joelvonrotz/KiCAD-Library/README.md

# KiCAD-Library

Collection of all my KiCAD Components (Footprints, 3D-Models &amp; Symbols)

I don't intend to commercialize anything from it, since some of the models here were take from the official kicad repository (and I don't know how legal it is to have a copy of the repository here &rarr; if you're a creator of one of those models or the script used to generate these and DON'T want to have them here, please message me!).

> [!important]
> Database not working, just added to work on it later
