joelvonrotz/KiCAD-Library/3dmodels/Package_QFP/CREDITS.md

# Extension by Joel

- These models have been take from https://gitlab.com/kicad/libraries/kicad-packages3D

---

## Footprint Library Credits

The credits of 3D models are listed in respective folder.  
Please fill all 3D models credits and info source data accordingly.  

### Info requirements:
- Author
- if the 3D model is script generated, a link to the script generator is required as well as the version and sw used
- if the 3D model is manually generated, include the source model @ https://github.com/KiCad/packages3D-source

<hr>  

### Housings_QFP.3dshapes:  
main author: Maurice easyw (others in script files)
3D step & wrl parametric models generated by scripts (step in scale 1:1 mm, wrl derived from step and scaled 1/2.54)  
[FCAD_script_generator](https://github.com/easyw/kicad-3d-models-in-freecad/tree/master/cadquery/FCAD_script_generator)  
release version of sw used to create models:  
- FreeCAD 0.17  
- CadQuery 0.5.2
