joelvonrotz/KiCAD-Library/3dmodels/Package_SO/CREDITS.md

# Extension by Joel

- These models have been take from https://gitlab.com/kicad/libraries/kicad-packages3D

---

## Footprint Library Credits

The credits of 3D models are listed in respective folder.  
Please fill all 3D models credits and info source data accordingly.  

### Info requirements:
- Author
- if the 3D model is script generated, a link to the script generator is required as well as the version and sw used
- if the 3D model is manually generated, include the source model @ https://github.com/KiCad/packages3D-source

<hr>

### Package_SO.3dshapes
main author: Maurice easyw (others in script files)
3D step & wrl parametric models generated by scripts (step in scale 1:1 mm, wrl derived from step and scaled 1/2.54)  
[FCAD_script_generator](https://github.com/easyw/kicad-3d-models-in-freecad/tree/master/cadquery/FCAD_script_generator)  
release version of sw used to create models:  
- FreeCAD 0.15 or FreeCAD 0.17 >= 10647  
- CadQuery 0.5.2  

SOIC-14_3.9x8.7mm_Pitch1.27mm  
SOIC-16W_7.5x10.3mm_Pitch1.27mm  
SOIC-16_3.9x9.9mm_Pitch1.27mm  
SOIC-18W_7.5x11.6mm_Pitch1.27mm  
SOIC-20W_7.5x12.8mm_Pitch1.27mm  
SOIC-24W_7.5x15.4mm_Pitch1.27mm  
SOIC-28W_7.5x17.9mm_Pitch1.27mm  
SOIC-8-1EP_3.9x4.9mm_Pitch1.27mm  
SOIC-8_3.9x4.9mm_Pitch1.27mm  
SOIJ-8_5.3x5.3mm_Pitch1.27mm  
MSOP-8-1EP_3x3mm_P0.65mm  
SSOP-20_5.3x7.2mm_P0.65mm  
TSSOP-14_4.4x5mm_P0.65mm  
QSOP-24_3.9x8.7mm_P0.635mm (https://github.com/easyw/kicad-3d-models-in-freecad/pull/31 joe-skb7)
ETSSOP-20-1EP_4.4x6.5mm_P0.65mm  
HTSSOP-20-1EP_4.4x6.5mm_P0.65mm_ThermalPad  
HTSSOP-28_4.4x9.7mm_P0.65mm_ThermalPad  
MSOP-10-1EP_3x3mm_P0.5mm  
MSOP-10_3x3mm_P0.5mm  
MSOP-12-16-1EP_3x4mm_P0.5mm  
MSOP-12-16_3x4mm_P0.5mm  
MSOP-12-1EP_3x4mm_P0.65mm  
MSOP-12_3x4mm_P0.65mm  
MSOP-16-1EP_3x4mm_P0.5mm  
MSOP-16_3x4mm_P0.5mm  
MSOP-8_3x3mm_P0.65mm  
OnSemi_Micro8  
PSOP-44_16.9x27.17mm_P1.27mm  
QSOP-16_3.9x4.9mm_P0.635mm  
SOP-16_4.4x10.4mm_P1.27mm  
SOP-4_4.4x2.8mm_P1.27mm  
SSOP-14_5.3x6.2mm_P0.65mm  
SSOP-16_3.9x4.9mm_P0.635mm  
SSOP-16_4.4x5.2mm_P0.65mm  
SSOP-16_5.3x6.2mm_P0.65mm  
SSOP-20_4.4x6.5mm_P0.65mm  
SSOP-24_3.9x8.7mm_P0.635mm  
SSOP-24_5.3x8.2mm_P0.65mm  
SSOP-28_5.3x10.2mm_P0.65mm  
SSOP-48_7.5x15.9mm_P0.635mm  
SSOP-56_7.5x18.5mm_P0.635mm  
SSOP-8_2.95x2.8mm_P0.65mm  
TSOP-I-48_12x18.4mm_P0.5mm  
TSOP-II-32_21.0x10.2mm_P1.27mm  
TSSOP-10_3x3mm_P0.5mm  
TSSOP-16-1EP_4.4x5mm_P0.65mm  
TSSOP-16_4.4x5mm_P0.65mm  
TSSOP-20_4.4x6.5mm_P0.65mm  
TSSOP-24_4.4x7.8mm_P0.65mm  
TSSOP-28_4.4x9.7mm_P0.65mm  
TSSOP-32_6.1x11mm_P0.65mm  
TSSOP-38_4.4x9.7mm_P0.5mm  
TSSOP-44_4.4x11.2mm_P0.5mm  
TSSOP-48_6.1x12.5mm_P0.5mm  
TSSOP-56_6.1x14mm_P0.5mm  
TSSOP-8_3x3mm_P0.65mm  
TSSOP-8_4.4x3mm_P0.65mm  
VSO-40_7.6x15.4mm_P0.762mm  
VSO-56_11.1x21.5mm_P0.75mm  
VSSOP-8_2.3x2mm_P0.5mm  
VSSOP-8_2.4x2.1mm_P0.5mm
SOP-4_3.8x4.1mm_P2.54mm

### Package_SO.3dshapes
main author: Stefan Olsson
3D step & wrl parametric models generated by scripts (step in scale 1:1 mm, wrl derived from step and scaled 1/2.54)  
[FCAD_script_generator](https://github.com/easyw/kicad-3d-models-in-freecad/tree/master/cadquery/FCAD_script_generator)  
release version of sw used to create models:  
- FreeCAD FreeCAD 0.17 Build 11223 64 bit Microsoft windwos platform https://www.freecadweb.org/

MFSOP6-4 (script)
MFSOP6-5 (script)
SO-20_12.8x7.5mm_Pitch1.27mm (modeled)
