joelvonrotz/KiCAD-Library/database/public_media/cache/thumbnail_md/media/part/23/mainimage-65ff1f30849ff.png

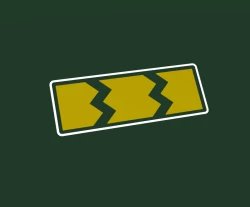
database/public_media/cache/thumbnail_md/media/part/23/mainimage-65ff1f30849ff.png
