joelvonrotz/KiCAD-Library/database/public_media/cache/thumbnail_md/media/part/24/mainimage-65ff1fbbb5337.png

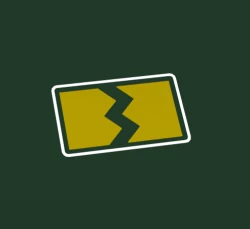
database/public_media/cache/thumbnail_md/media/part/24/mainimage-65ff1fbbb5337.png
