joelvonrotz/KiCAD-Library/database/public_media/cache/thumbnail_md/media/part/33/mainimage-65fecf4a8bd5e.png

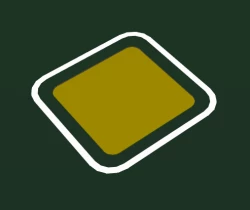
database/public_media/cache/thumbnail_md/media/part/33/mainimage-65fecf4a8bd5e.png
