joelvonrotz/KiCAD-Library/database/public_media/part/mainimage-66267fba0766b.png

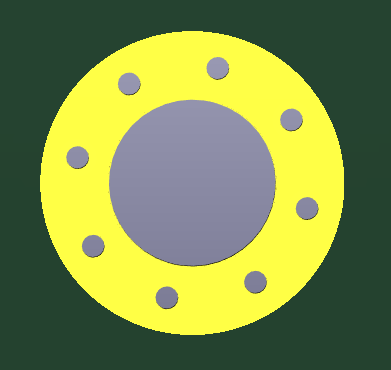
database/public_media/part/mainimage-66267fba0766b.png
