joelvonrotz/KiCAD-Library/3dmodels/Amphenol/sma_straight_tht_jack_132134.stp

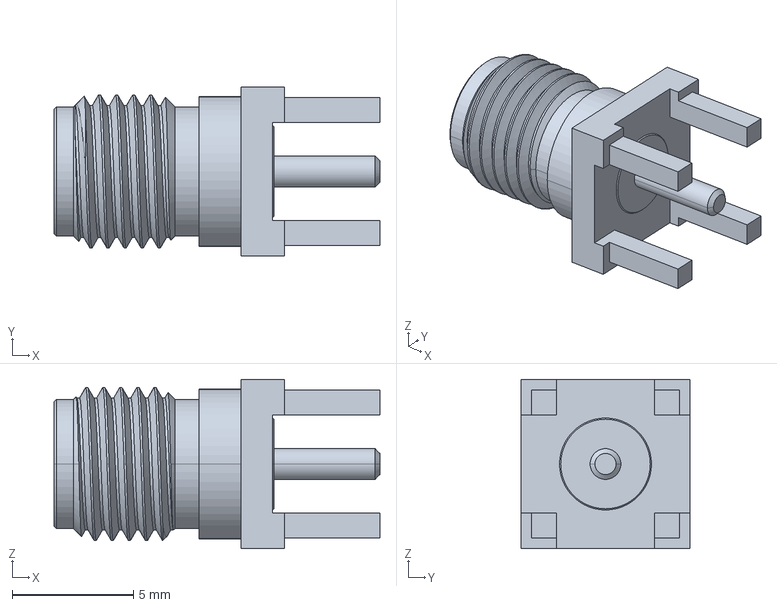
[picture p6: CAD file, 2024-11-03]
3dmodels/Amphenol/sma_straight_tht_jack_132134.stp
13.5 x 7.00 x 7.00 mm
