joelvonrotz/KiCAD-Library/3dmodels/Bourns/Resettable Multifuse/mf-msmf050.stp

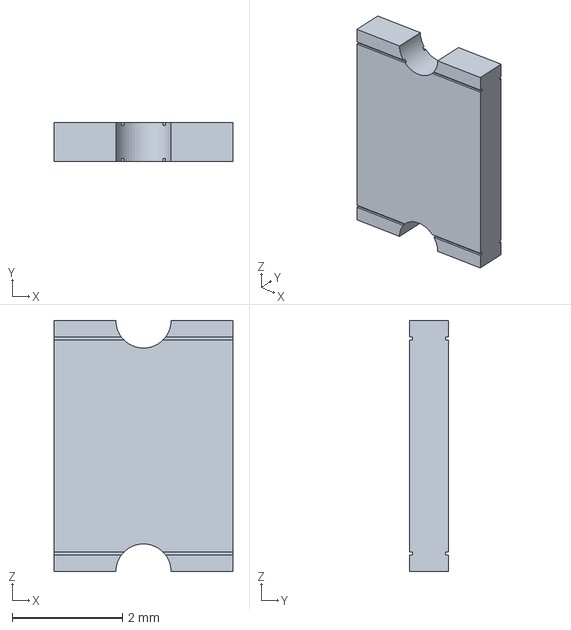
[picture p7: CAD file, 2021-02-06]
3dmodels/Bourns/Resettable Multifuse/mf-msmf050.stp
3.24 x 0.7 x 4.55 mm
