joelvonrotz/KiCAD-Library/3dmodels/C&K/tactile_button/PTS820J25KSMTRLFS.stp

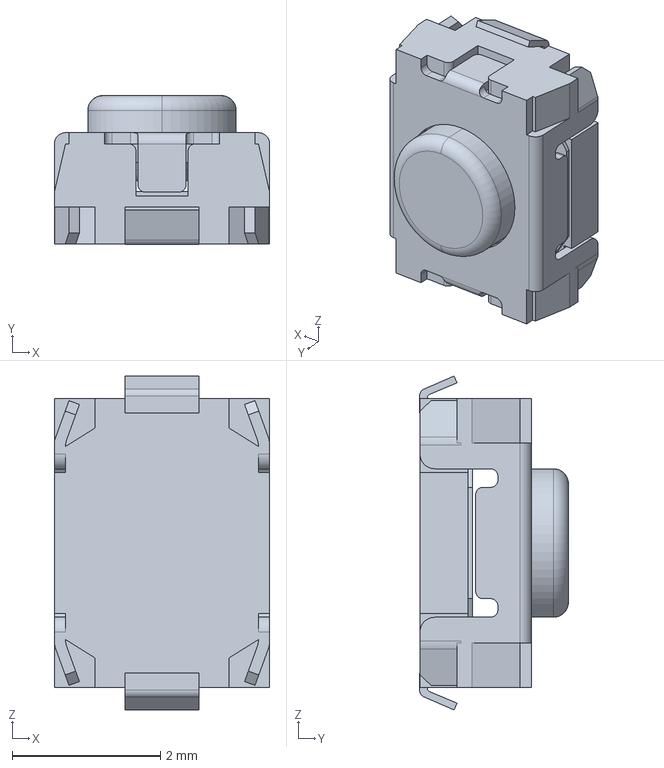
[picture p8: CAD file, 2024-05-29]
3dmodels/C&K/tactile_button/PTS820J25KSMTRLFS.stp
2.90 x 2.00 x 4.50 mm
