joelvonrotz/KiCAD-Library/3dmodels/capacitor/smd/CAP2225.stp

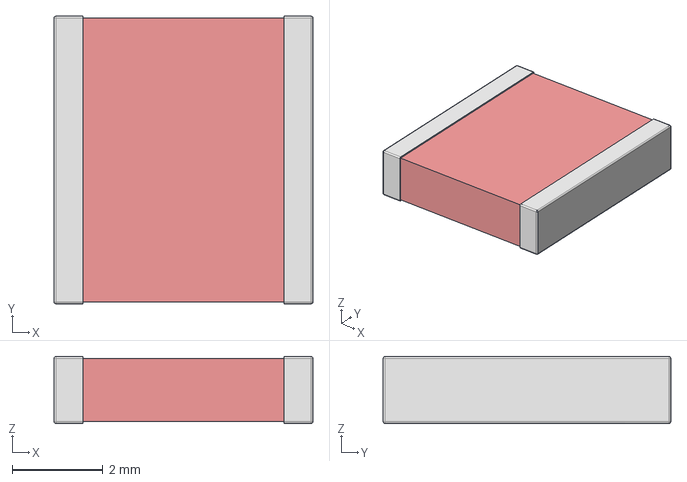
[picture p9: CAD file, 2021-02-06]
3dmodels/capacitor/smd/CAP2225.stp
5.72 x 6.35 x 1.48 mm
