joelvonrotz/KiCAD-Library/3dmodels/Discretes/DO-219AD v1.step

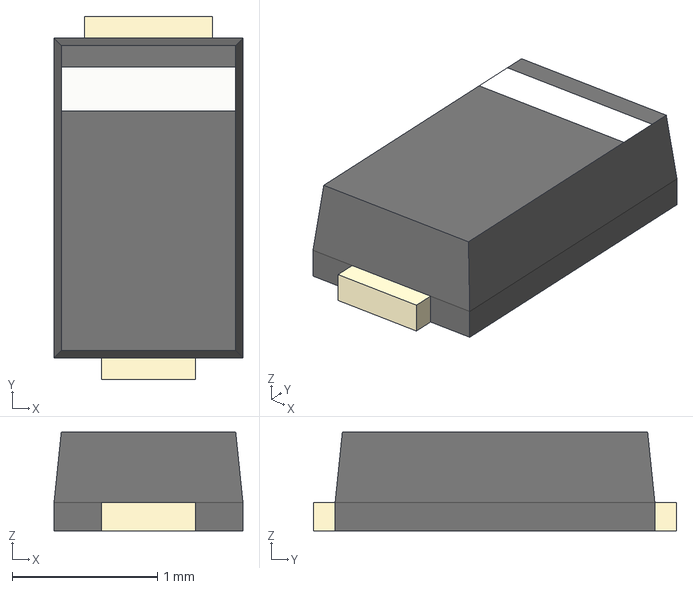
[picture p10: CAD file, 2021-02-06]
3dmodels/Discretes/DO-219AD v1.step
1.30 x 2.50 x 0.68 mm
