joelvonrotz/KiCAD-Library/3dmodels/Harwin/testpoints/S2751-46R.STEP

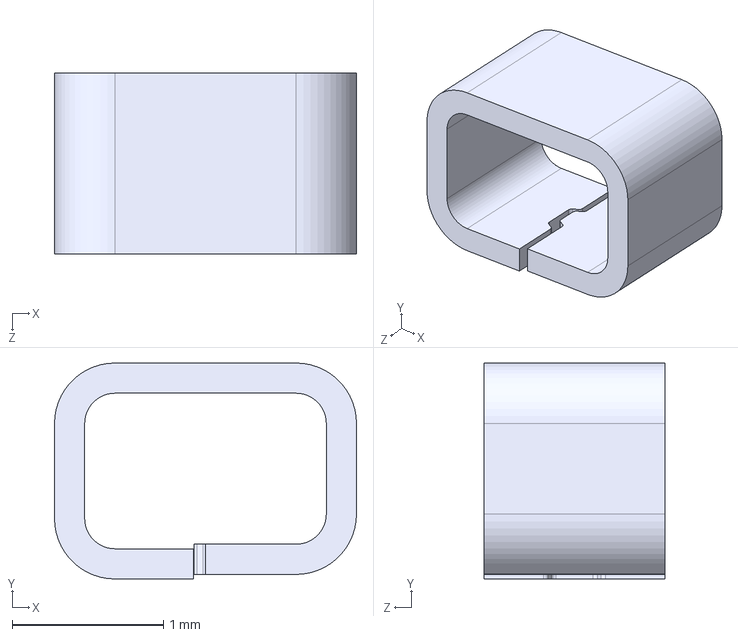
[picture p11: CAD file, 2024-11-03]
3dmodels/Harwin/testpoints/S2751-46R.STEP
2.00 x 1.43 x 1.20 mm
