joelvonrotz/KiCAD-Library/3dmodels/Kingbright/APT1608.STEP

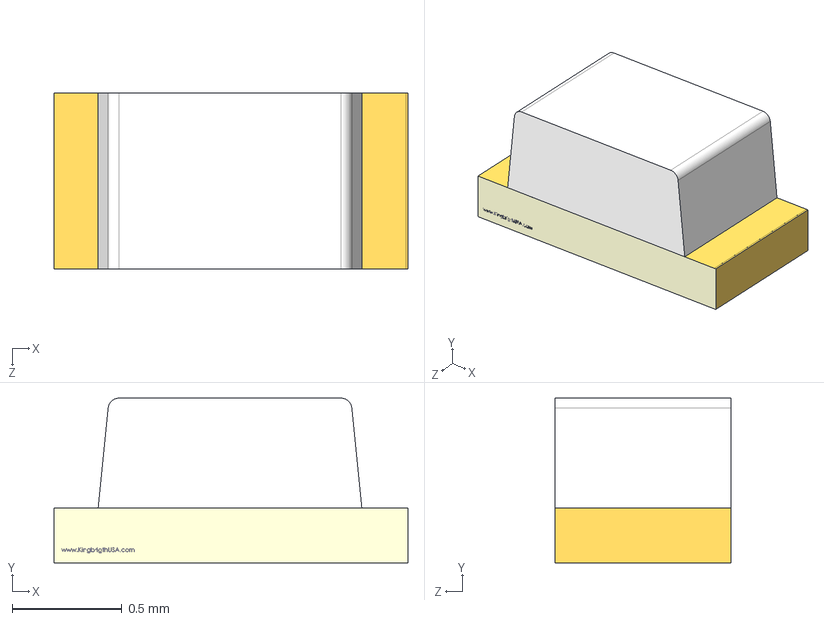
[picture p12: CAD file, 2024-11-03]
3dmodels/Kingbright/APT1608.STEP
1.61 x 0.75 x 0.8 mm
