joelvonrotz/KiCAD-Library/3dmodels/Murata/Inductor/LQG18HH68NJ00D.STEP

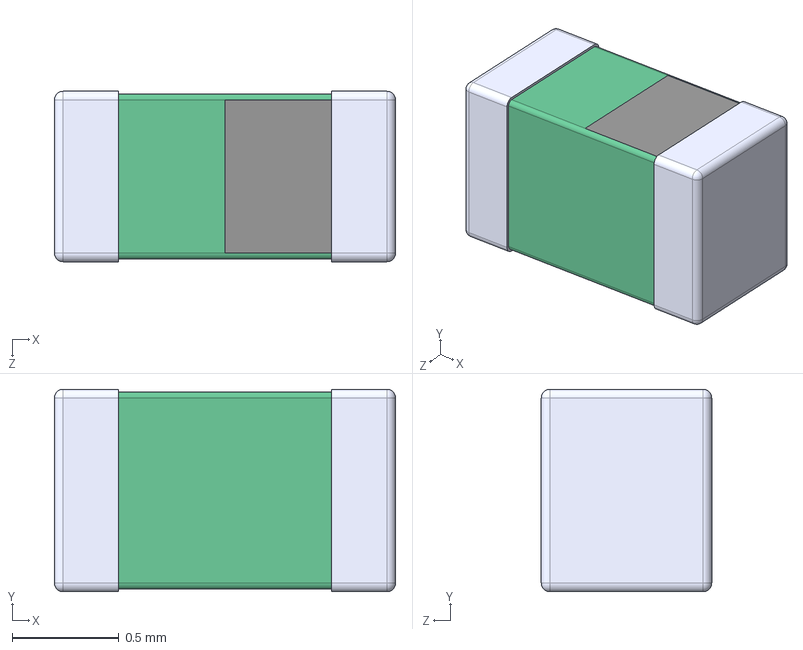
[picture p13: CAD file, 2024-11-04]
3dmodels/Murata/Inductor/LQG18HH68NJ00D.STEP
1.60 x 0.95 x 0.8 mm
