joelvonrotz/KiCAD-Library/3dmodels/Murata/Resonators/Murata_CSTNE_V v1.step

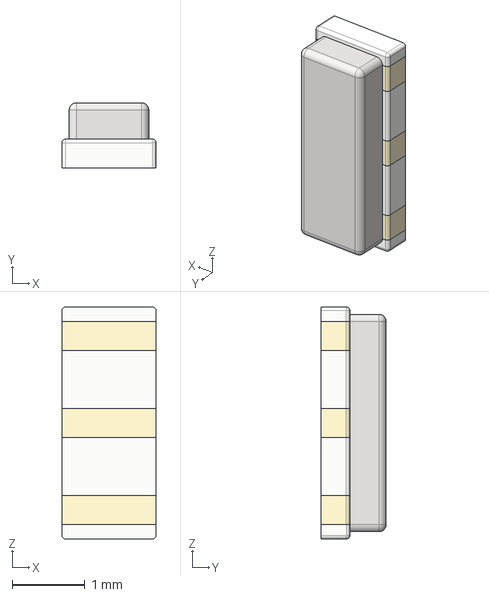
[picture p14: CAD file, 2021-02-06]
3dmodels/Murata/Resonators/Murata_CSTNE_V v1.step
1.30 x 0.9 x 3.20 mm
