joelvonrotz/KiCAD-Library/3dmodels/Package_ECS/ECS-3225_ECS.step

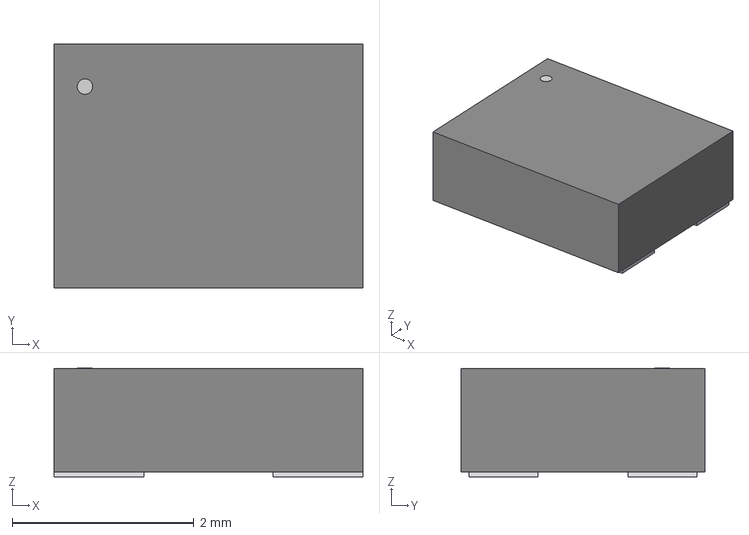
[picture p15: CAD file, 2024-03-18]
3dmodels/Package_ECS/ECS-3225_ECS.step
3.40 x 2.69 x 1.20 mm
