joelvonrotz/KiCAD-Library/3dmodels/Package_QFN/QFN-24-4x4mm_P0.5mm.step

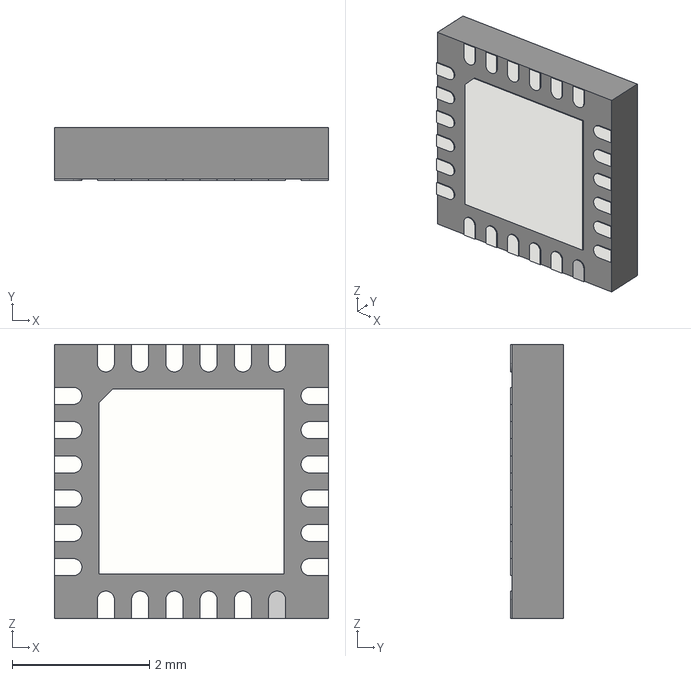
[picture p16: CAD file, 2024-05-29]
3dmodels/Package_QFN/QFN-24-4x4mm_P0.5mm.step
4.00 x 0.77 x 4.00 mm
