joelvonrotz/KiCAD-Library/3dmodels/Package_QFP/TQFP-100_14x14mm_P0.5mm_EP5x5mm.step

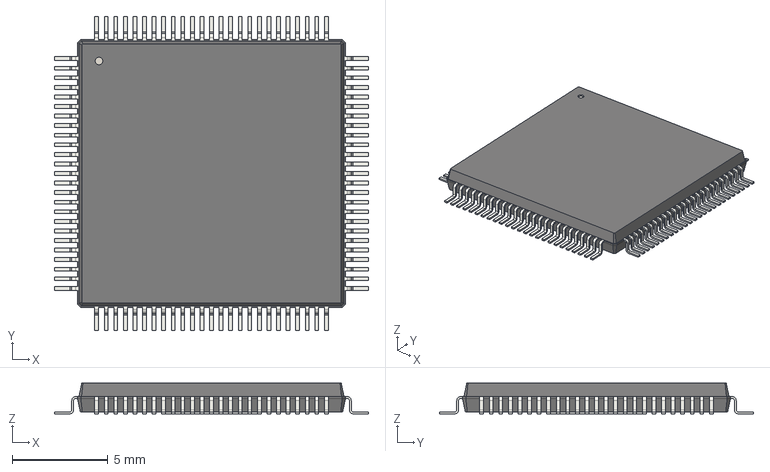
[picture p17: CAD file, 2021-02-06]
3dmodels/Package_QFP/TQFP-100_14x14mm_P0.5mm_EP5x5mm.step
16.4 x 16.4 x 1.60 mm
