joelvonrotz/KiCAD-Library/3dmodels/Package_SO/TSSOP-14-1EP_4.4x5mm_P0.65mm.step

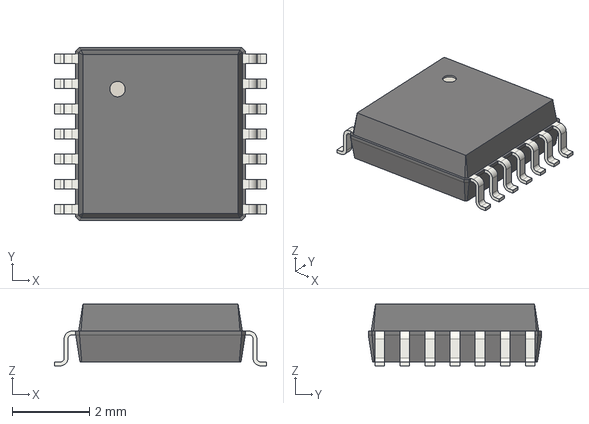
[picture p18: CAD file, 2021-02-06]
3dmodels/Package_SO/TSSOP-14-1EP_4.4x5mm_P0.65mm.step
5.50 x 4.50 x 1.60 mm
