joelvonrotz/KiCAD-Library/3dmodels/Package_SOT/SOT363.step

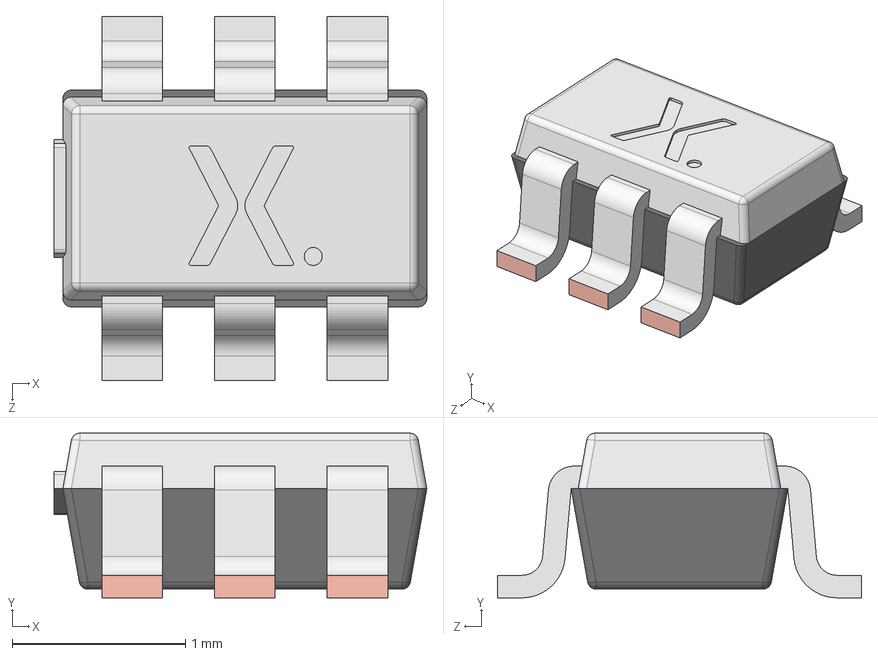
[picture p19: CAD file, 2024-11-04]
3dmodels/Package_SOT/SOT363.step
2.15 x 0.95 x 2.10 mm
SOT353 Lower body
SOT353 Lead x 6
SOT353 Upper body
