joelvonrotz/KiCAD-Library/3dmodels/Package_TFQFPN/TFQFPN24_4x4_p0.5.step

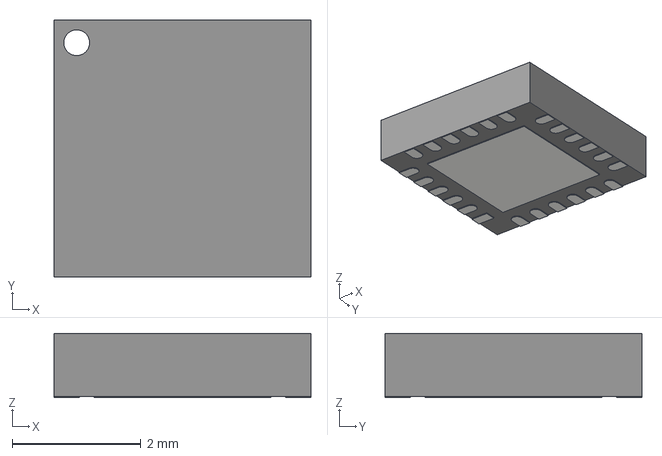
[picture p20: CAD file, 2024-05-29]
3dmodels/Package_TFQFPN/TFQFPN24_4x4_p0.5.step
4.00 x 4.00 x 1.00 mm
