joelvonrotz/KiCAD-Library/3dmodels/Package_UFQFPN/UFQFPN-28.step

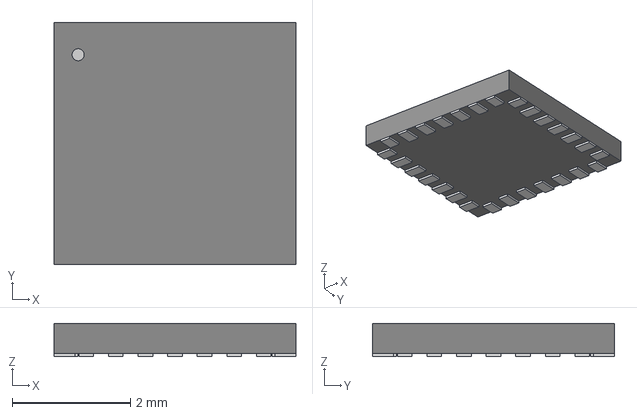
[picture p21: CAD file, 2024-03-18]
3dmodels/Package_UFQFPN/UFQFPN-28.step
4.09 x 4.09 x 0.561 mm
