joelvonrotz/KiCAD-Library/3dmodels/Package_UQFN/UQFN10_RSW0010A.stp

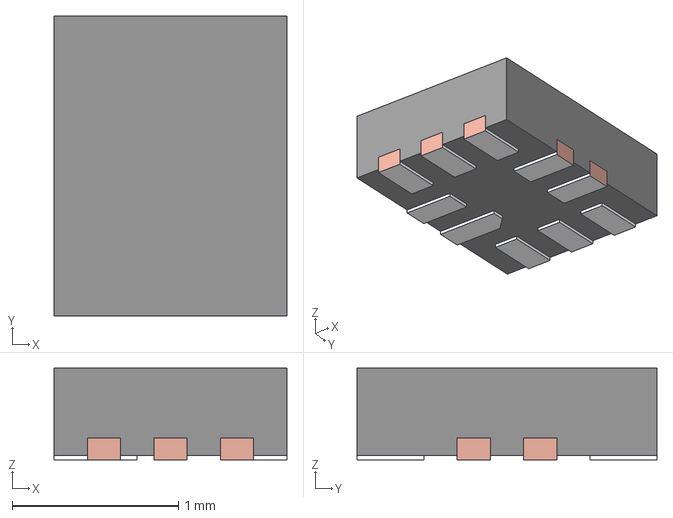
[picture p22: CAD file, 2024-11-04]
3dmodels/Package_UQFN/UQFN10_RSW0010A.stp
1.40 x 1.80 x 0.55 mm
FRAME
