joelvonrotz/KiCAD-Library/3dmodels/Package_uSIP/uSIP-11.iges

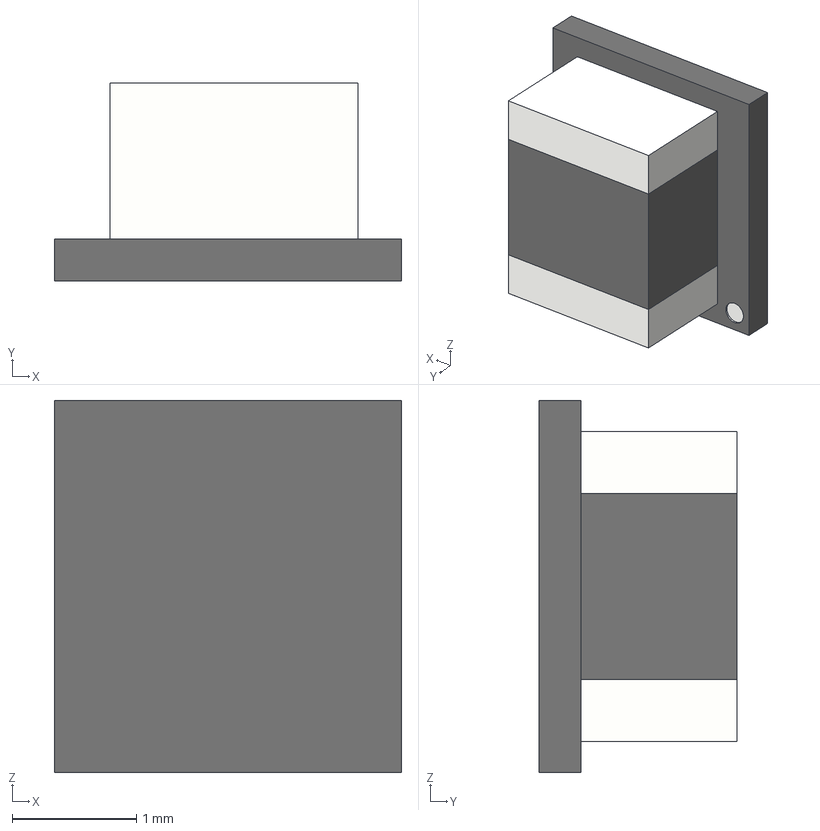
[picture p23: CAD file, 2024-03-18]
3dmodels/Package_uSIP/uSIP-11.iges
2.80 x 1.60 x 3.00 mm
