joelvonrotz/KiCAD-Library/3dmodels/Package_VQFN/VQFN14-FCRLF_RXB0014A.stp

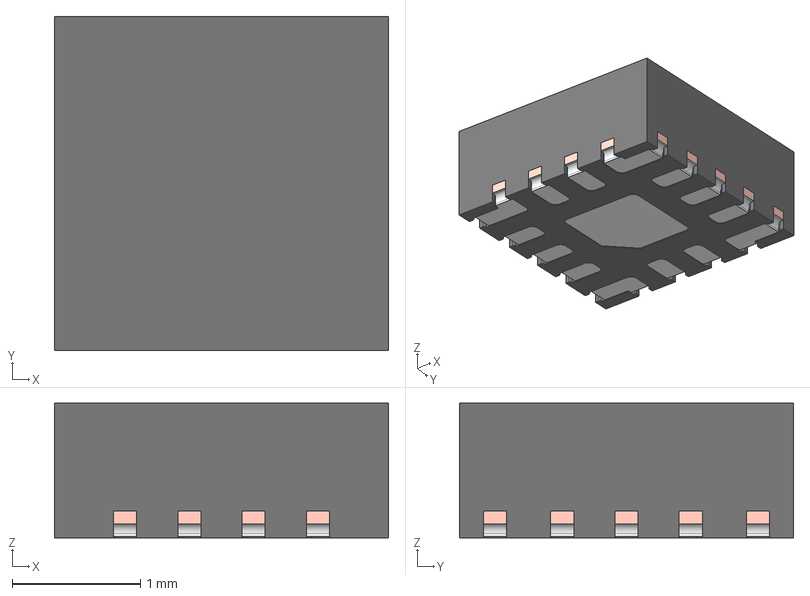
[picture p24: CAD file, 2024-11-05]
3dmodels/Package_VQFN/VQFN14-FCRLF_RXB0014A.stp
2.60 x 2.60 x 1.05 mm
FRAME
PIN1_AREA
