joelvonrotz/KiCAD-Library/3dmodels/Package_WQFN/WQFN10_BQB0016A.stp

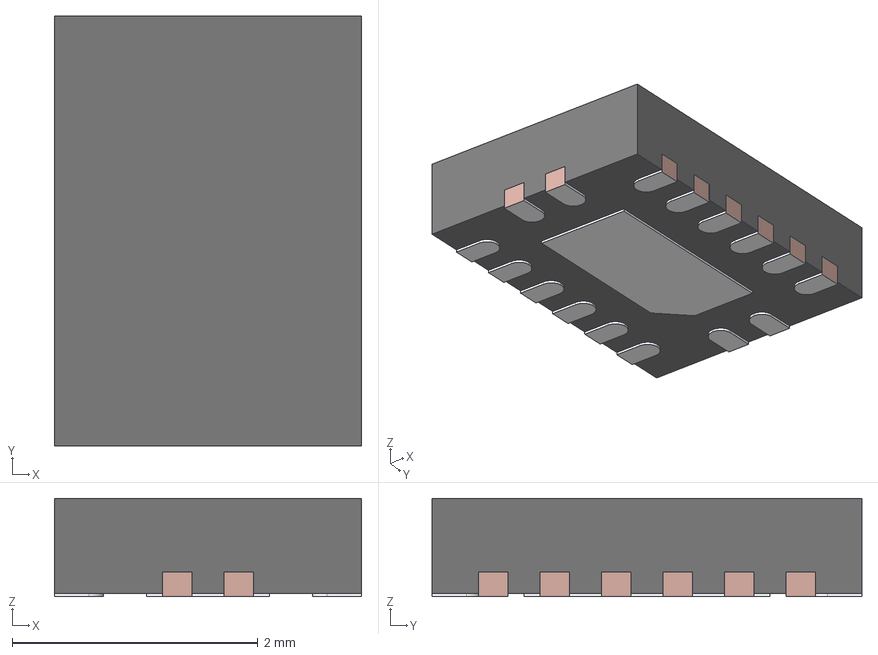
[picture p25: CAD file, 2024-11-04]
3dmodels/Package_WQFN/WQFN10_BQB0016A.stp
2.50 x 3.50 x 0.8 mm
FRAME
