joelvonrotz/KiCAD-Library/3dmodels/PhoenixContact/pxc_1725672_09_02_MPT-0-5-4-2-54_3D.stp

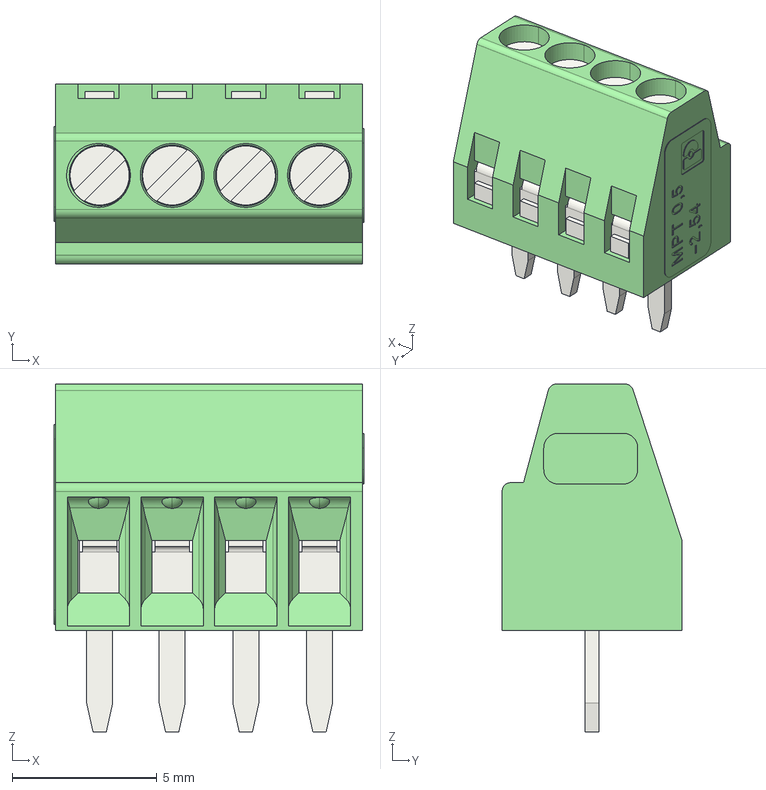
[picture p26: CAD file, 2024-05-29]
3dmodels/PhoenixContact/pxc_1725672_09_02_MPT-0-5-4-2-54_3D.stp
10.7 x 6.20 x 12.0 mm
