joelvonrotz/KiCAD-Library/3dmodels/Pin header jumper.stp

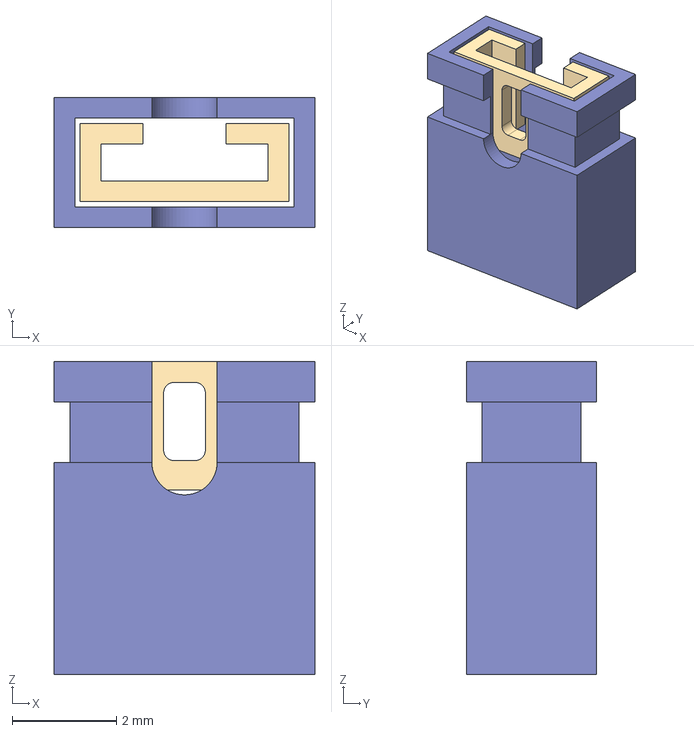
[picture p27: CAD file, 2024-11-05]
3dmodels/Pin header jumper.stp
5.00 x 2.50 x 6.00 mm
