joelvonrotz/KiCAD-Library/3dmodels/Preci-Dip/pcb_connector_803-87-004-10-001101.stp

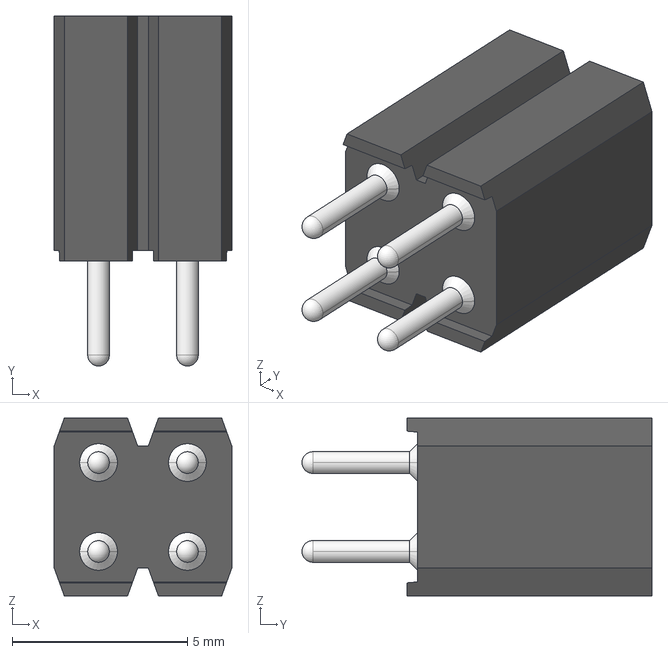
[picture p28: CAD file, 2024-10-17]
3dmodels/Preci-Dip/pcb_connector_803-87-004-10-001101.stp
5.08 x 10.00 x 5.08 mm
