joelvonrotz/KiCAD-Library/3dmodels/Preci-Dip/Socket Connector 2.54mm 7mm/pcb_connector_801-87-010-10-001101.stp

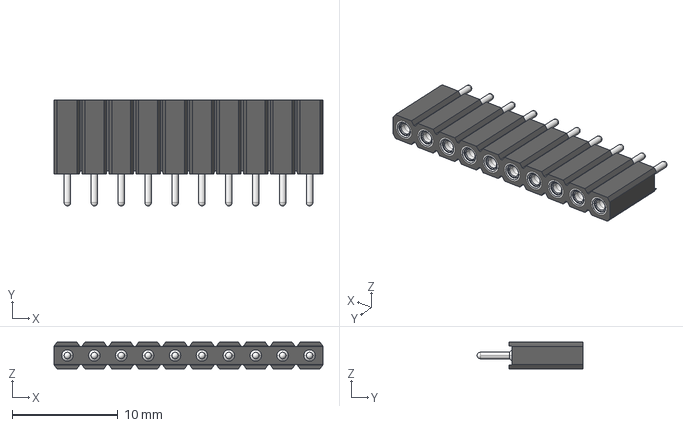
[picture p29: CAD file, 2024-12-04]
3dmodels/Preci-Dip/Socket Connector 2.54mm 7mm/pcb_connector_801-87-010-10-001101.stp
25.4 x 10.00 x 2.54 mm
