joelvonrotz/KiCAD-Library/3dmodels/resistor/smd/RES0402.stp

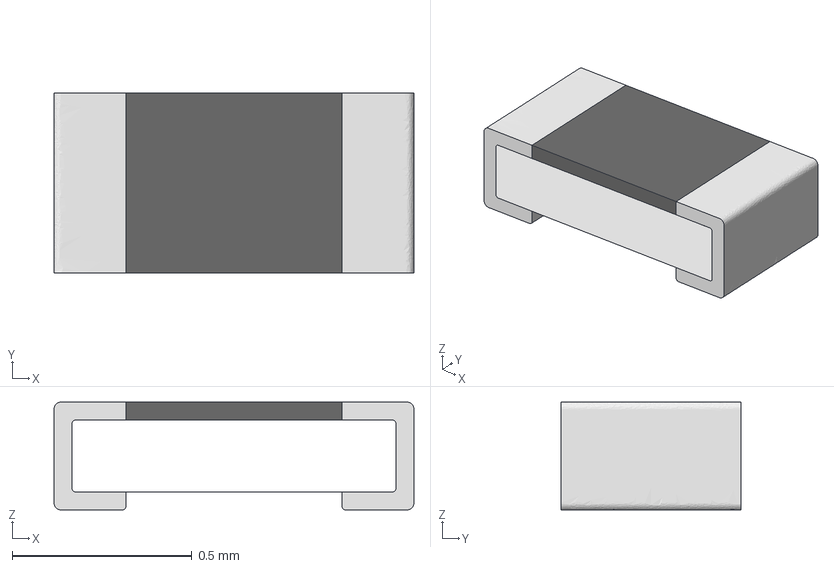
[picture p30: CAD file, 2021-02-06]
3dmodels/resistor/smd/RES0402.stp
1.00 x 0.5 x 0.3 mm
