joelvonrotz/KiCAD-Library/3dmodels/Samtec/CLP_1.27mm_Socket/CLP-112-02-L-D.stp

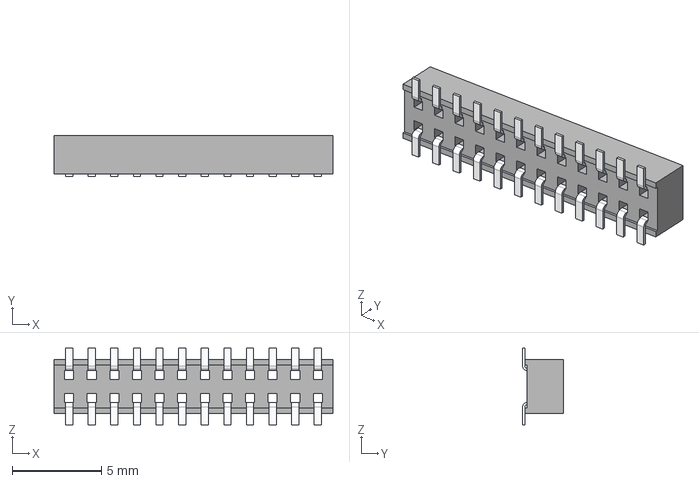
[picture p31: CAD file, 2024-11-03]
3dmodels/Samtec/CLP_1.27mm_Socket/CLP-112-02-L-D.stp
15.7 x 2.29 x 4.32 mm
CLP-112-2-L-D_terminal
C-106-22-1-L-12_Pin x 2
