joelvonrotz/KiCAD-Library/3dmodels/Samtec/FTS_1.27mm_Header/FTS-112-01-L-DV.stp

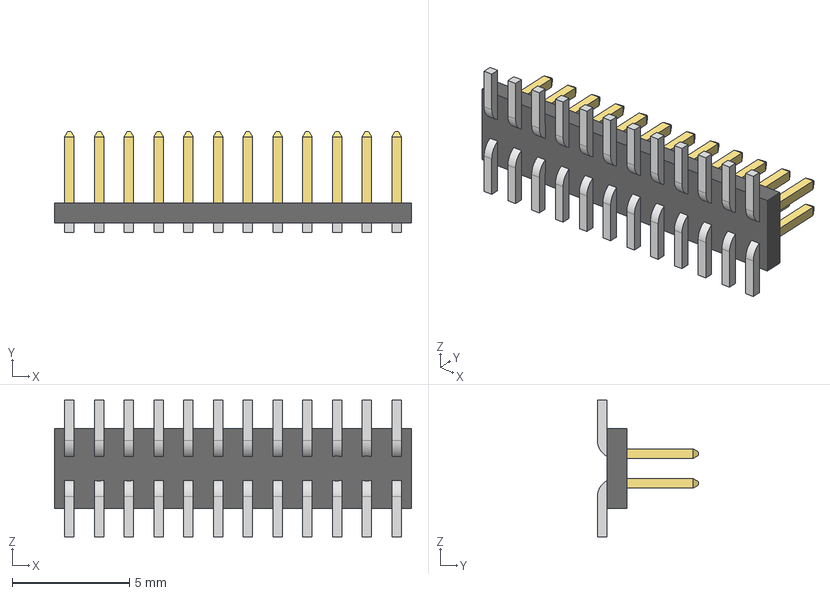
[picture p32: CAD file, 2024-11-03]
3dmodels/Samtec/FTS_1.27mm_Header/FTS-112-01-L-DV.stp
15.2 x 4.32 x 5.84 mm
FTS-112-01-L-DV_body
FTS-112-01-L-DV_pins1
FTS-112-01-L-DV_pins2
