joelvonrotz/KiCAD-Library/3dmodels/Samtec/TSW/double/TSW-102-07-G-D.stp

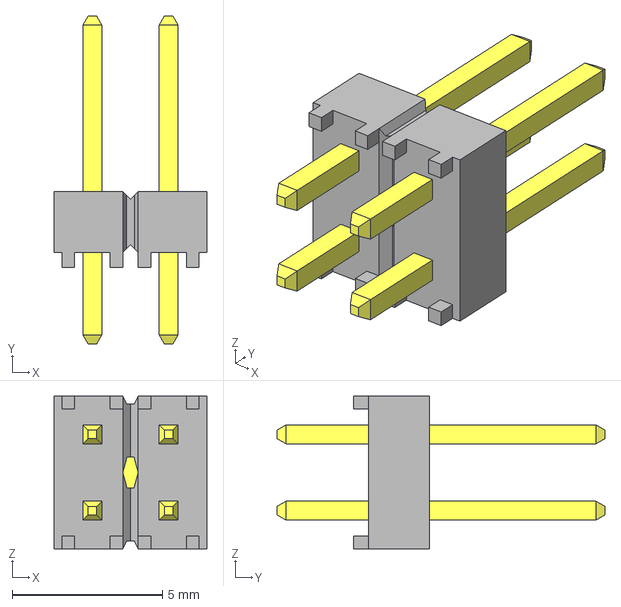
[picture p34: CAD file, 2024-12-04]
3dmodels/Samtec/TSW/double/TSW-102-07-G-D.stp
5.08 x 10.9 x 5.08 mm
TSW-102-07-G-D_body
T-1S6-07-TSW-1-07-2-D
