joelvonrotz/KiCAD-Library/3dmodels/Sumida/CDRH6D28.step

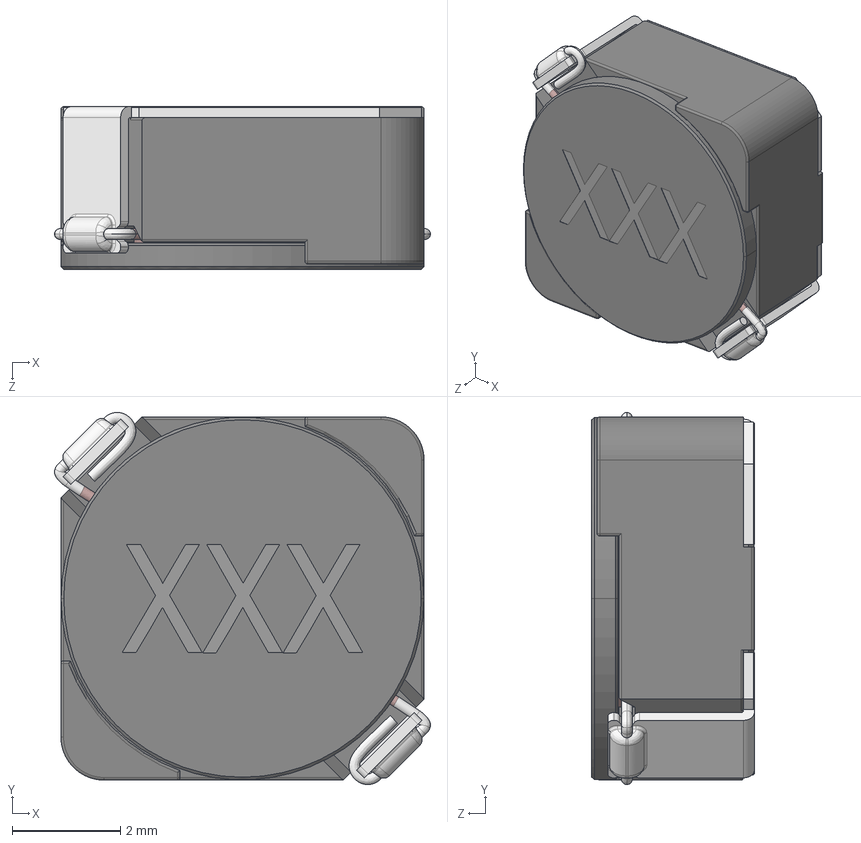
[picture p36: CAD file, 2024-11-05]
3dmodels/Sumida/CDRH6D28.step
6.93 x 6.86 x 3.00 mm
