joelvonrotz/KiCAD-Library/3dmodels/C&K/tactile_button/KMR711NGLFS.stp

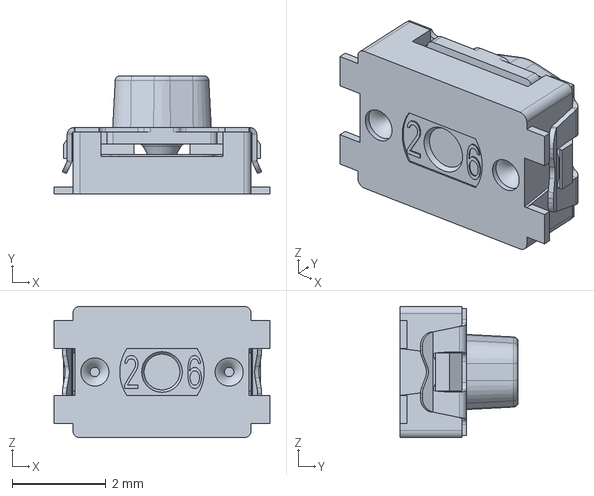
[picture p37: CAD file, 2021-02-06]
3dmodels/C&K/tactile_button/KMR711NGLFS.stp
4.60 x 2.52 x 2.80 mm
