joelvonrotz/KiCAD-Library/3dmodels/capacitor/smd/CAP0805.stp

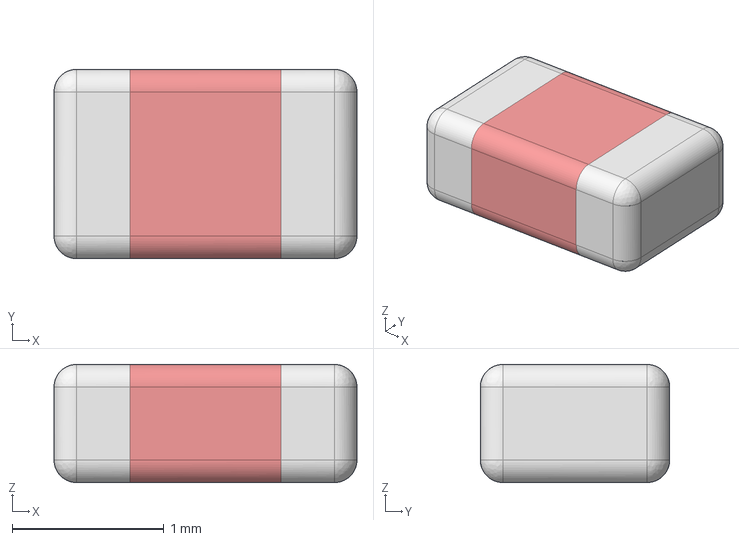
[picture p38: CAD file, 2021-02-06]
3dmodels/capacitor/smd/CAP0805.stp
2.00 x 1.25 x 0.78 mm
