joelvonrotz/KiCAD-Library/3dmodels/Harwin/testpoints/s2761-46r.stp

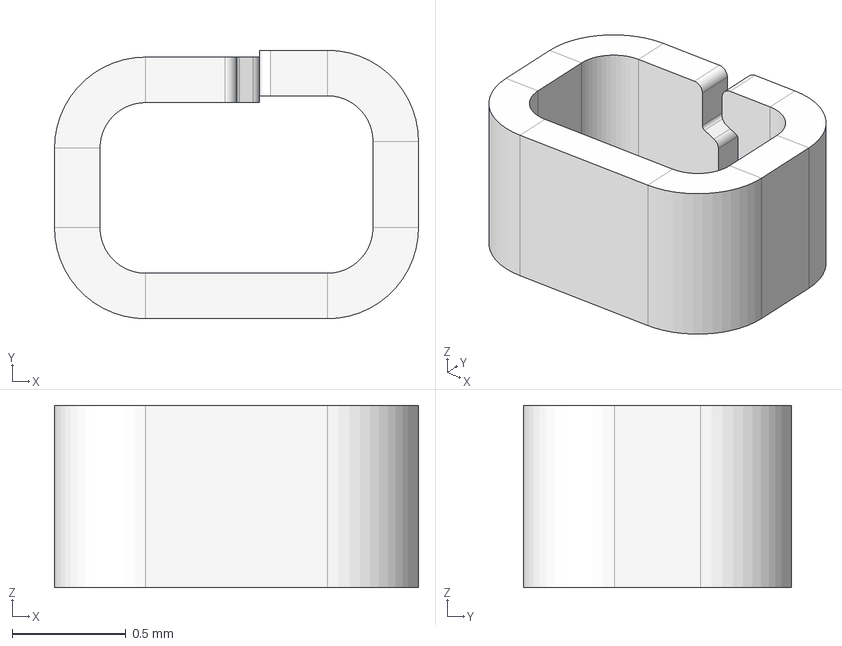
[picture p39: CAD file, 2024-05-29]
3dmodels/Harwin/testpoints/s2761-46r.stp
1.60 x 1.18 x 0.8 mm
