joelvonrotz/KiCAD-Library/3dmodels/Murata/Inductor/LQG15HS68NJ02D.step

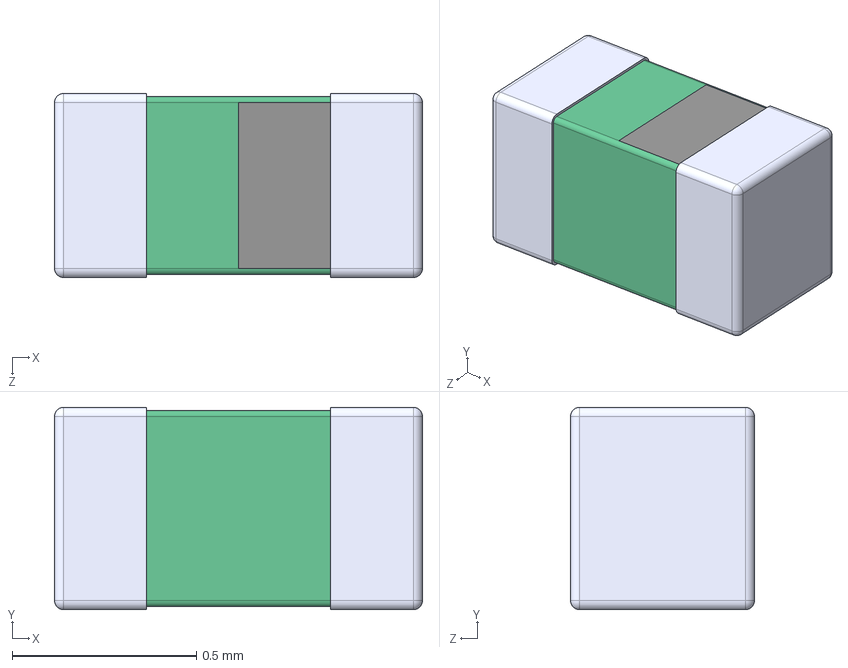
[picture p40: CAD file, 2024-11-04]
3dmodels/Murata/Inductor/LQG15HS68NJ02D.step
1.00 x 0.55 x 0.5 mm
