joelvonrotz/KiCAD-Library/3dmodels/Package_QFN/QFN-56-1EP_7x7mm_P0.4mm_EP5.6x5.6mm.step

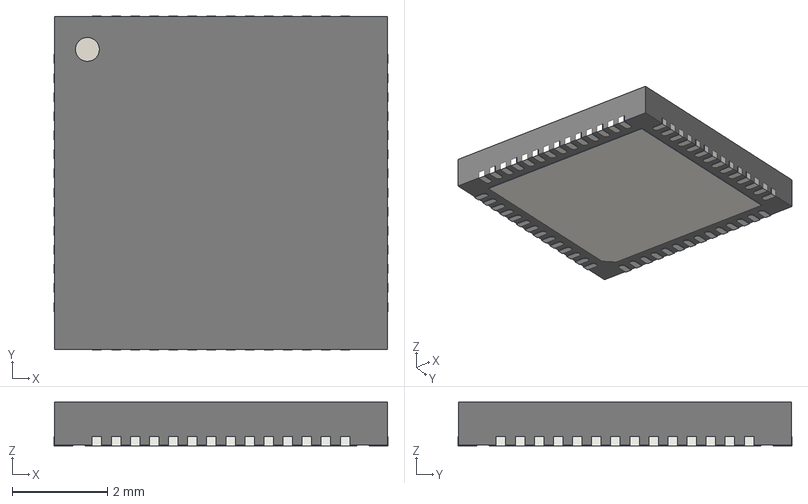
[picture p41: CAD file, 2024-03-18]
3dmodels/Package_QFN/QFN-56-1EP_7x7mm_P0.4mm_EP5.6x5.6mm.step
7.00 x 7.00 x 0.92 mm
