joelvonrotz/KiCAD-Library/3dmodels/Package_QFP/LQFP-32_5x5mm_P0.5mm.step

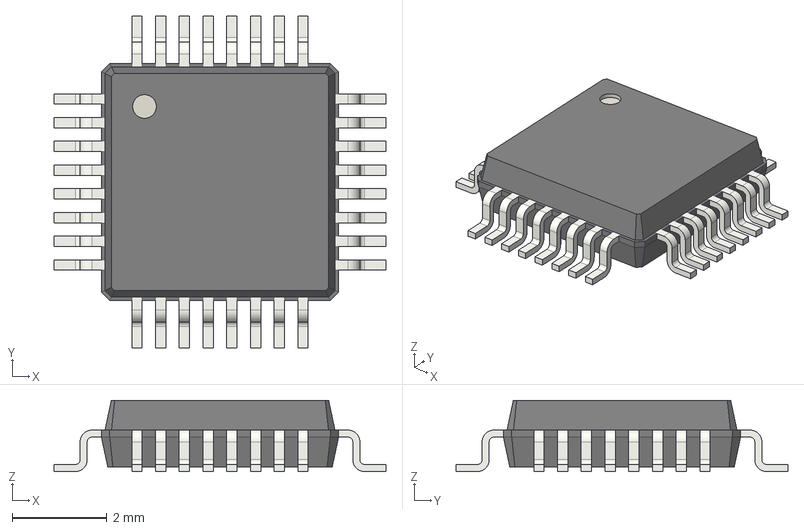
[picture p42: CAD file, 2021-02-06]
3dmodels/Package_QFP/LQFP-32_5x5mm_P0.5mm.step
7.00 x 7.00 x 1.50 mm
