joelvonrotz/KiCAD-Library/3dmodels/Package_SO/TSSOP-28_8x9.7mm_P0.65mm.step

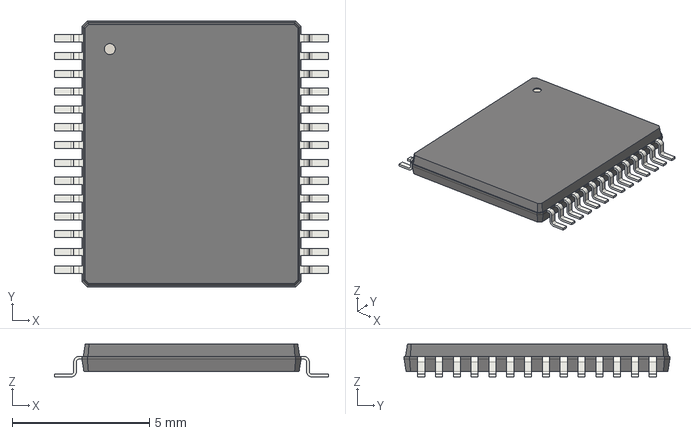
[picture p43: CAD file, 2021-02-06]
3dmodels/Package_SO/TSSOP-28_8x9.7mm_P0.65mm.step
10.0 x 9.70 x 1.20 mm
