joelvonrotz/KiCAD-Library/3dmodels/Package_SOT/SOT23-6L.STEP

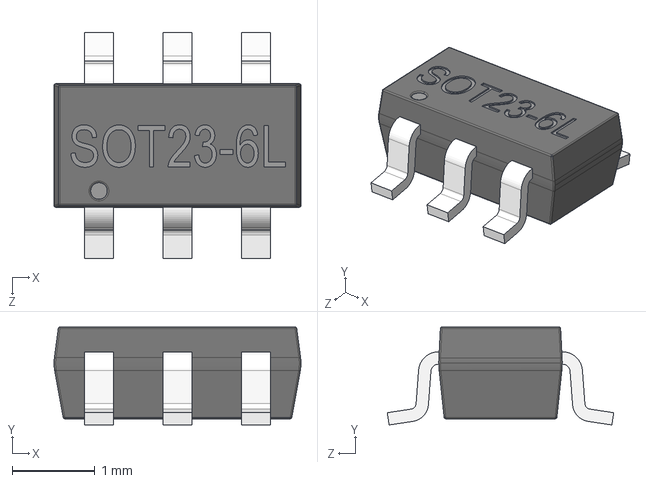
[picture p44: CAD file, 2024-11-03]
3dmodels/Package_SOT/SOT23-6L.STEP
2.99 x 1.18 x 2.74 mm
