joelvonrotz/KiCAD-Library/3dmodels/Package_VQFN/VQFN40_RGF_TEX.step

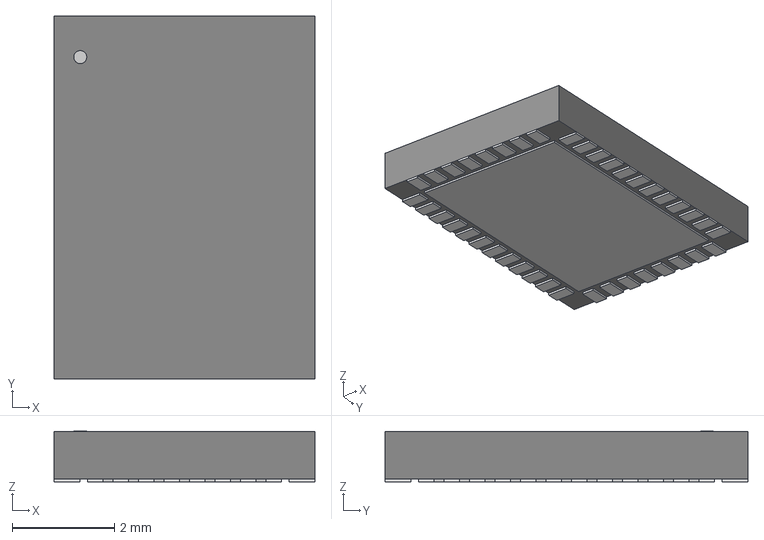
[picture p45: CAD file, 2024-05-29]
3dmodels/Package_VQFN/VQFN40_RGF_TEX.step
5.11 x 7.11 x 0.993 mm
