joelvonrotz/KiCAD-Library/3dmodels/resistor/smd/RES2512.stp

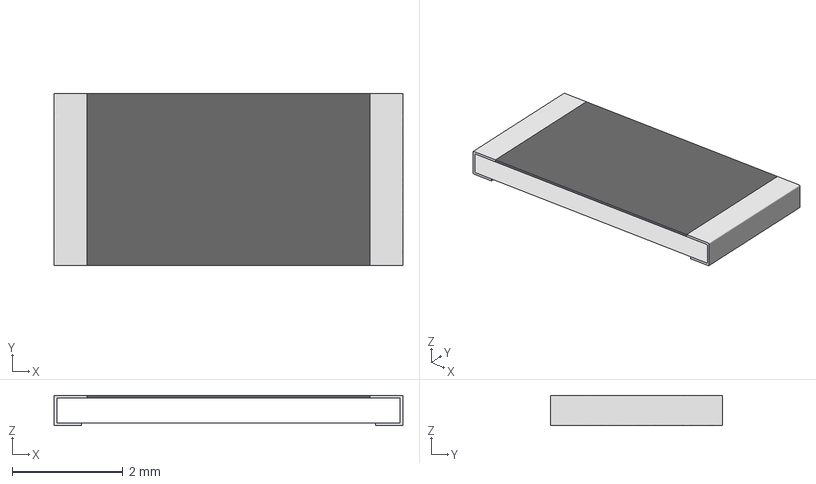
[picture p46: CAD file, 2021-02-06]
3dmodels/resistor/smd/RES2512.stp
6.30 x 3.10 x 0.55 mm
