joelvonrotz/KiCAD-Library/3dmodels/Samtec/CLP_1.27mm_Socket/CLP-106-02-L-D.stp

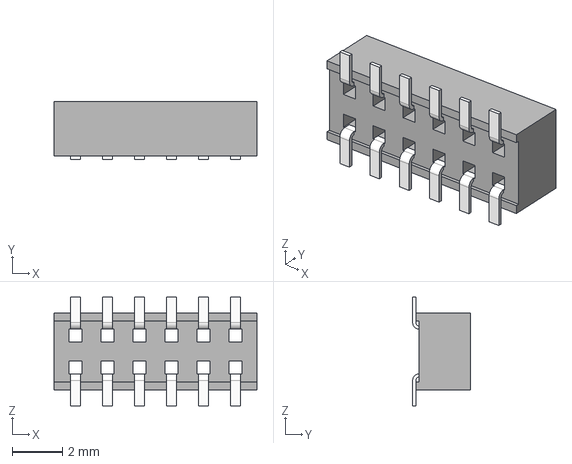
[picture p47: CAD file, 2024-11-03]
3dmodels/Samtec/CLP_1.27mm_Socket/CLP-106-02-L-D.stp
8.05 x 2.29 x 4.32 mm
CLP-106-2-L-D_terminal
C-106-22-1-L-06_Pin x 2
