joelvonrotz/KiCAD-Library/3dmodels/Samtec/FTS_1.27mm_Header/FTS-106-01-L-DV.stp

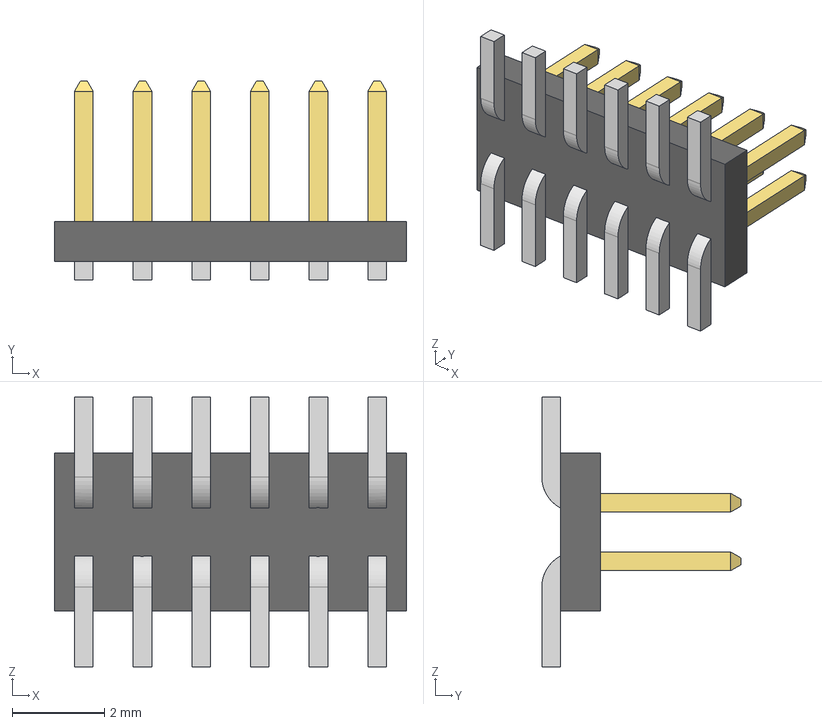
[picture p48: CAD file, 2024-11-03]
3dmodels/Samtec/FTS_1.27mm_Header/FTS-106-01-L-DV.stp
7.62 x 4.32 x 5.84 mm
FTS-106-01-L-DV_body
FTS-106-01-L-DV_pins1
FTS-106-01-L-DV_pins2
