joelvonrotz/KiCAD-Library/3dmodels/Samtec/TSW/double/TSW-103-07-G-D.stp

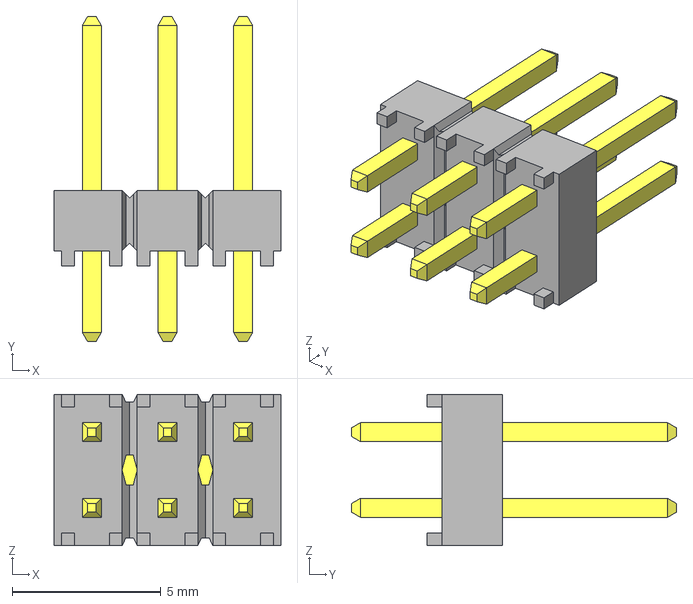
[picture p49: CAD file, 2021-02-06]
3dmodels/Samtec/TSW/double/TSW-103-07-G-D.stp
7.62 x 10.9 x 5.08 mm
_TSW-103-07-G-D_body
_T-1S6-07-TSW-1-07-3-D
