joelvonrotz/KiCAD-Library/3dmodels/C&K/tactile_button/KSC701JLFS.stp

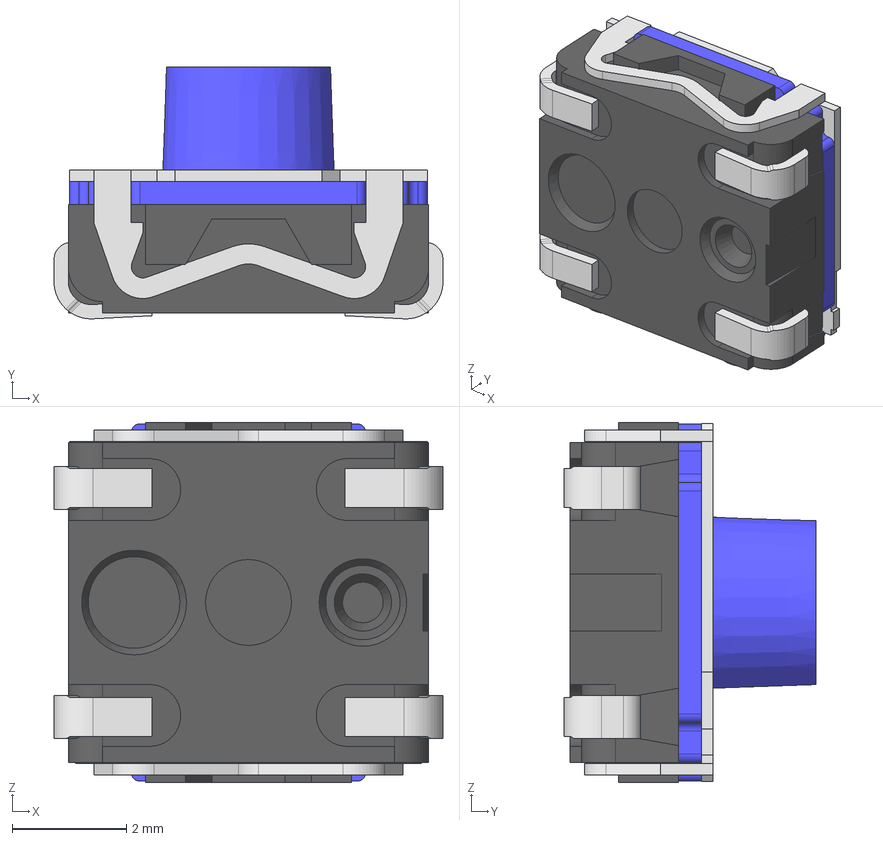
[picture p51: CAD file, 2021-02-06]
3dmodels/C&K/tactile_button/KSC701JLFS.stp
6.80 x 4.40 x 6.30 mm
_KSC7_body
_KSC7_button
_KSC7_cover
_KSC71J_pin x 4
