joelvonrotz/KiCAD-Library/3dmodels/capacitor/smd/CAP1210.stp

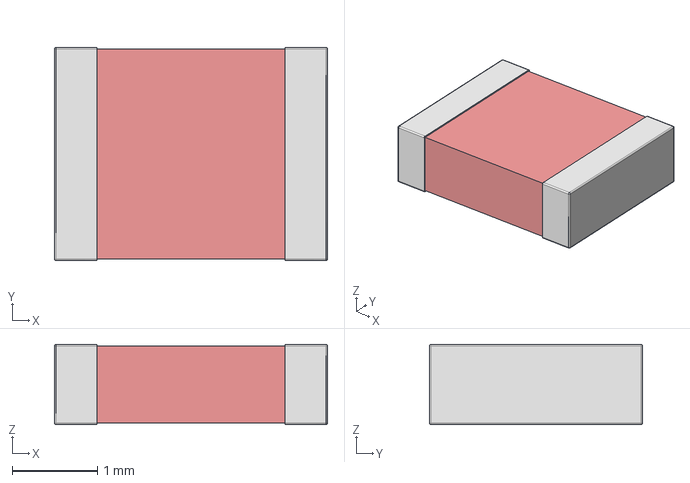
[picture p52: CAD file, 2021-02-06]
3dmodels/capacitor/smd/CAP1210.stp
3.20 x 2.50 x 0.94 mm
