joelvonrotz/KiCAD-Library/3dmodels/Package_QFN/QFN-56.STEP

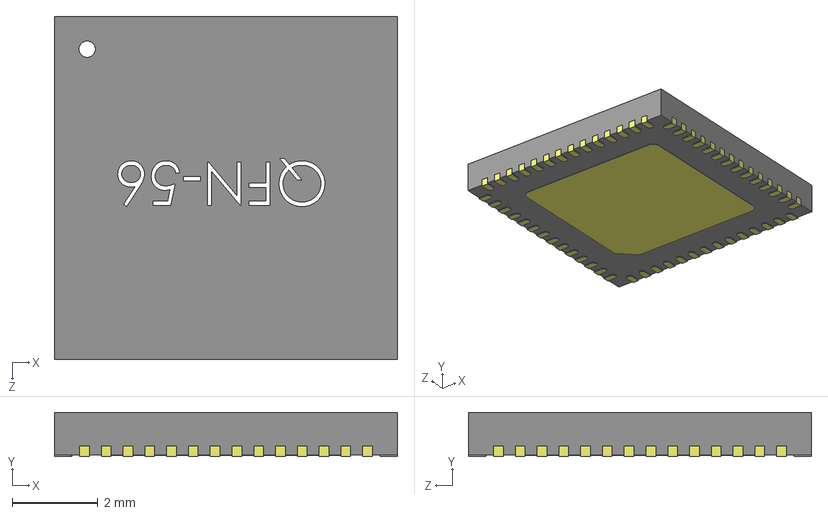
[picture p53: CAD file, 2024-03-18]
3dmodels/Package_QFN/QFN-56.STEP
8.00 x 1.03 x 8.00 mm
SW3dPS-QFN-56_QFN-56 Connector x 56
SW3dPS-QFN-56_QFN-56 Body
