joelvonrotz/KiCAD-Library/3dmodels/Package_QFP/TQFP-64_14x14mm_P0.8mm.step

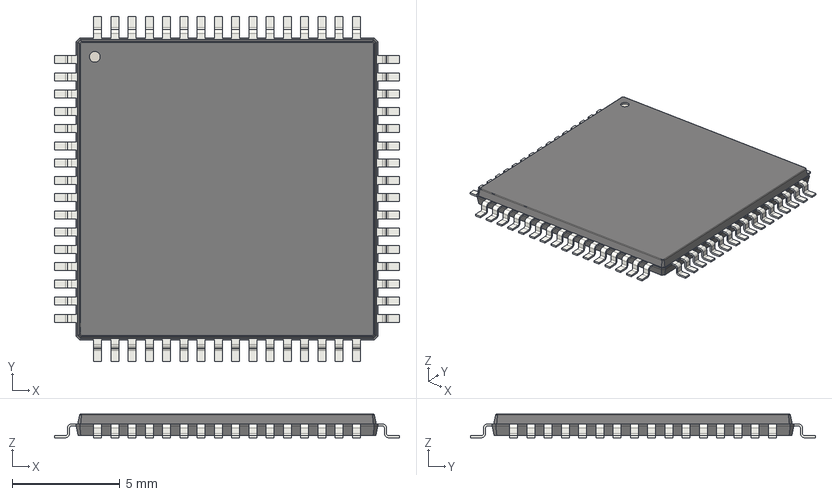
[picture p54: CAD file, 2021-02-06]
3dmodels/Package_QFP/TQFP-64_14x14mm_P0.8mm.step
16.0 x 16.0 x 1.10 mm
