joelvonrotz/KiCAD-Library/3dmodels/Package_SO/SOIC-16W_7.5x12.8mm_P1.27mm.step

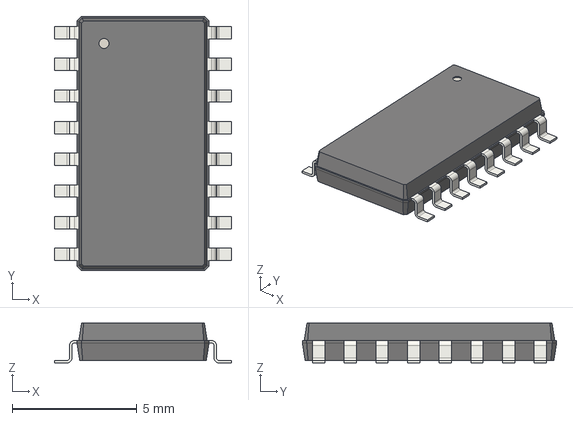
[picture p55: CAD file, 2021-02-06]
3dmodels/Package_SO/SOIC-16W_7.5x12.8mm_P1.27mm.step
7.10 x 10.2 x 1.60 mm
