joelvonrotz/KiCAD-Library/3dmodels/Package_SOT/SOT353.step

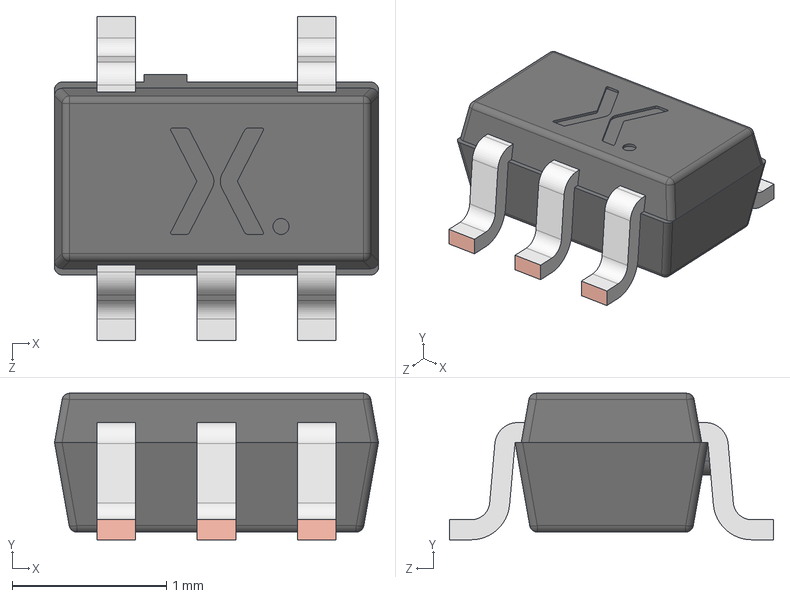
[picture p56: CAD file, 2024-05-29]
3dmodels/Package_SOT/SOT353.step
2.10 x 0.95 x 2.10 mm
SOT353 Lower body
SOT353 Lead x 5
SOT353 Upper body
