joelvonrotz/KiCAD-Library/3dmodels/Package_VQFN/VFQFPN-16_STM.step

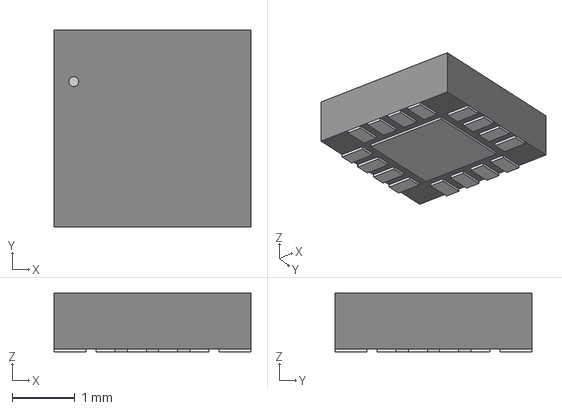
[picture p57: CAD file, 2024-05-29]
3dmodels/Package_VQFN/VFQFPN-16_STM.step
3.15 x 3.15 x 0.942 mm
