joelvonrotz/KiCAD-Library/3dmodels/resistor/smd/RES0603.stp

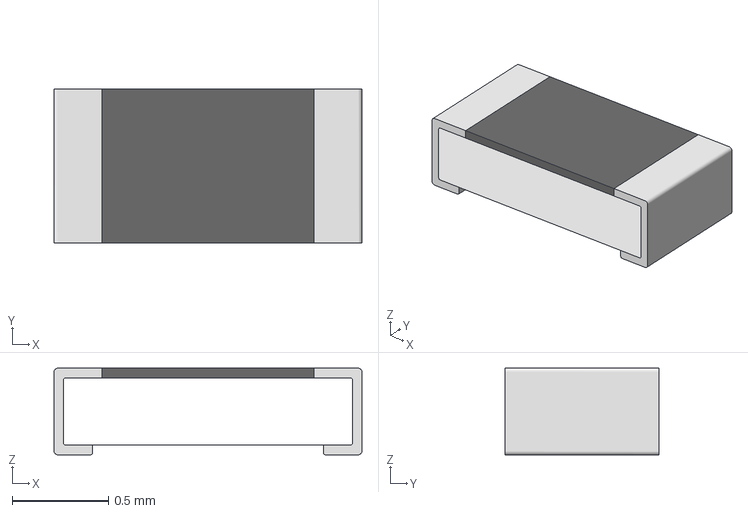
[picture p58: CAD file, 2021-02-06]
3dmodels/resistor/smd/RES0603.stp
1.60 x 0.8 x 0.45 mm
