joelvonrotz/KiCAD-Library/3dmodels/Samtec/TSW/single/TSW-102-07-G-S.stp

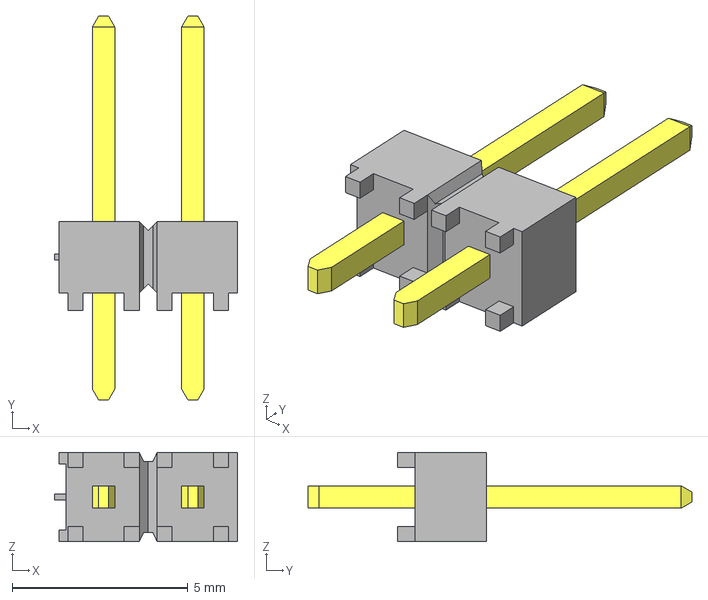
[picture p59: CAD file, 2021-02-06]
3dmodels/Samtec/TSW/single/TSW-102-07-G-S.stp
5.21 x 10.9 x 2.54 mm
_TSW-102-07-G-S_body
_T-1S6-07-TSW-1-07-2-S
