joelvonrotz/KiCAD-Library/3dmodels/capacitor/smd/CAP0402.stp

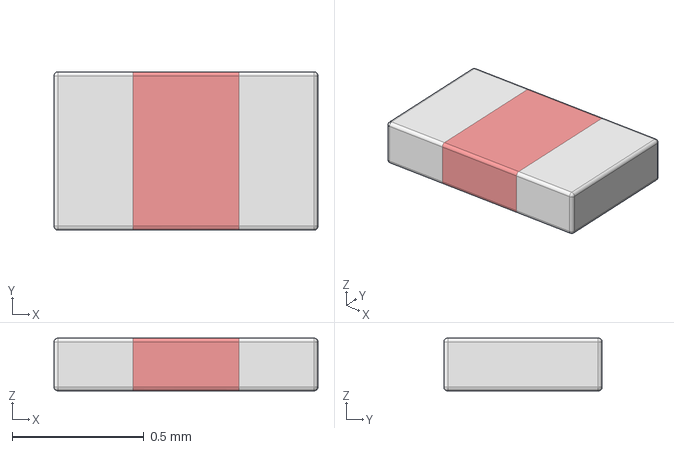
[picture p60: CAD file, 2021-02-06]
3dmodels/capacitor/smd/CAP0402.stp
1.00 x 0.6 x 0.2 mm
