joelvonrotz/KiCAD-Library/3dmodels/Package_SO/TSOP-I-28_11.8x8mm_P0.55mm.step

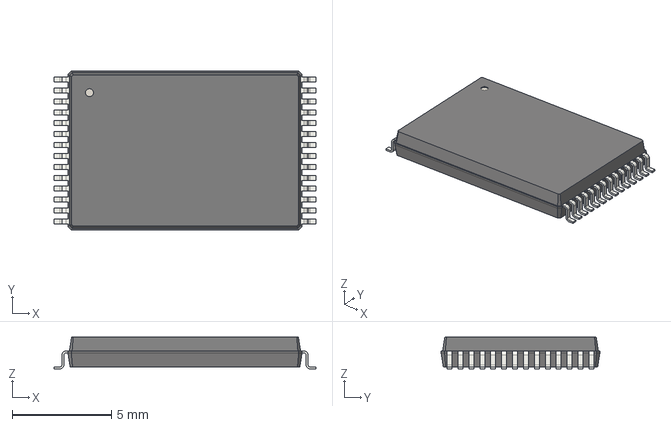
[picture p62: CAD file, 2021-02-06]
3dmodels/Package_SO/TSOP-I-28_11.8x8mm_P0.55mm.step
13.2 x 8.00 x 1.60 mm
