joelvonrotz/KiCAD-Library/3dmodels/Package_SOT/SOT1176-2.step

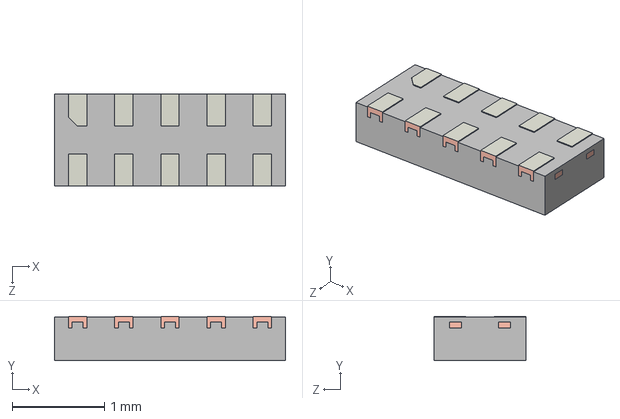
[picture p63: CAD file, 2024-05-29]
3dmodels/Package_SOT/SOT1176-2.step
2.50 x 0.48 x 1.00 mm
SOT1176-2 LF
SOT1176-2 Mold body
