joelvonrotz/KiCAD-Library/3dmodels/resistor/smd/RES0805.stp

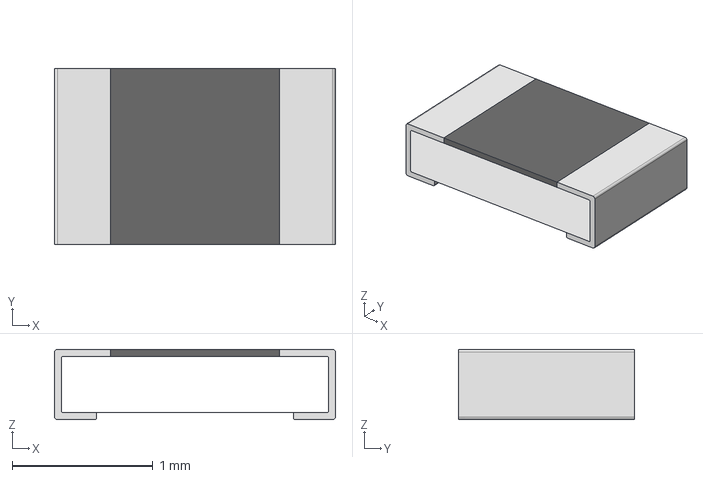
[picture p64: CAD file, 2021-02-06]
3dmodels/resistor/smd/RES0805.stp
2.00 x 1.25 x 0.5 mm
