joelvonrotz/KiCAD-Library/3dmodels/capacitor/smd/CAP2220.stp

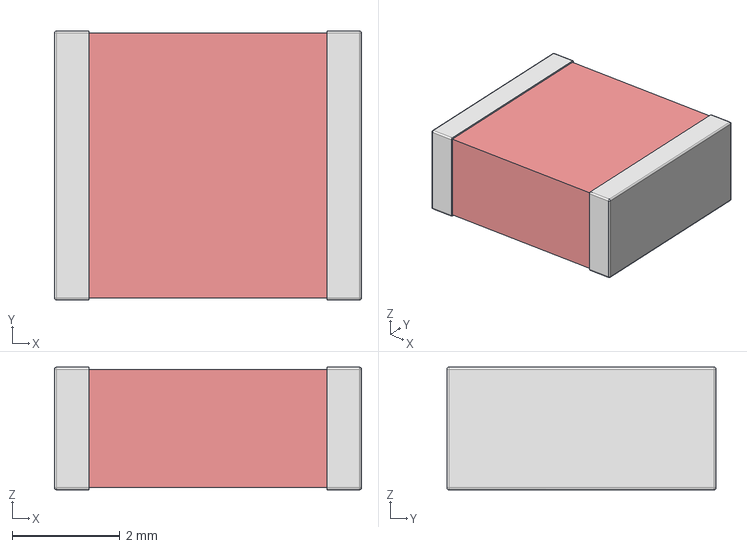
[picture p65: CAD file, 2021-02-06]
3dmodels/capacitor/smd/CAP2220.stp
5.70 x 5.00 x 2.28 mm
