joelvonrotz/KiCAD-Library/3dmodels/Package_QFP/LQFP-144_20x20mm_P0.5mm.step

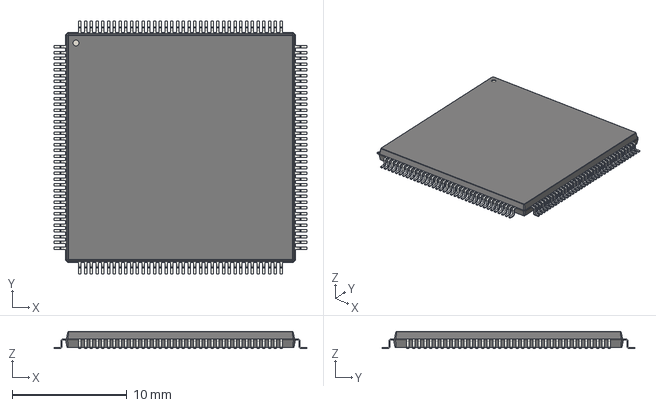
[picture p66: CAD file, 2021-02-06]
3dmodels/Package_QFP/LQFP-144_20x20mm_P0.5mm.step
22.0 x 22.0 x 1.50 mm
