joelvonrotz/KiCAD-Library/3dmodels/Package_SO/TSOP-I-48_18.4x12mm_P0.5mm.step

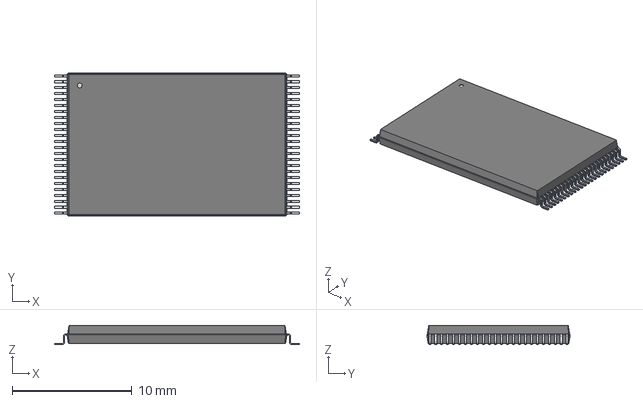
[picture p67: CAD file, 2021-02-06]
3dmodels/Package_SO/TSOP-I-48_18.4x12mm_P0.5mm.step
20.5 x 12.0 x 1.60 mm
