joelvonrotz/KiCAD-Library/3dmodels/resistor/smd/RES0201.stp

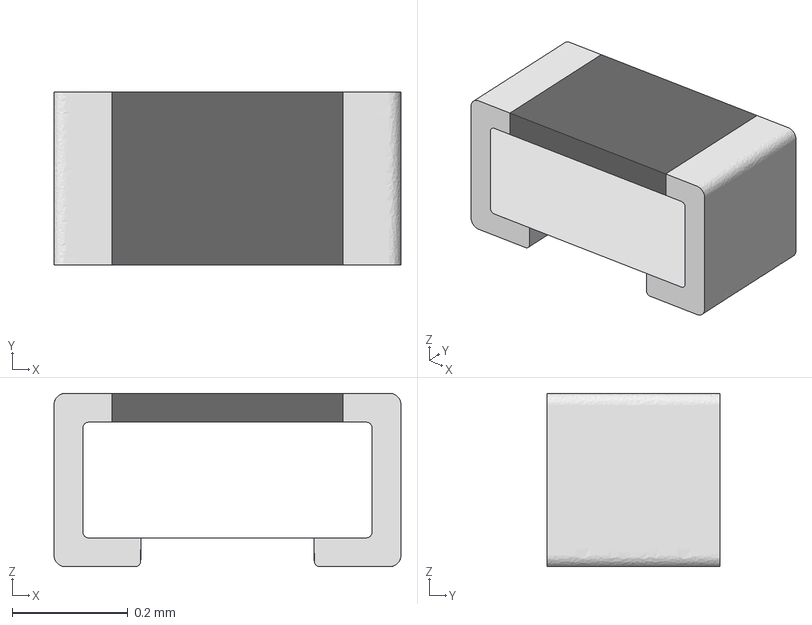
[picture p68: CAD file, 2021-02-06]
3dmodels/resistor/smd/RES0201.stp
0.6 x 0.3 x 0.3 mm
