joelvonrotz/KiCAD-Library/3dmodels/capacitor/smd/CAP1206.stp

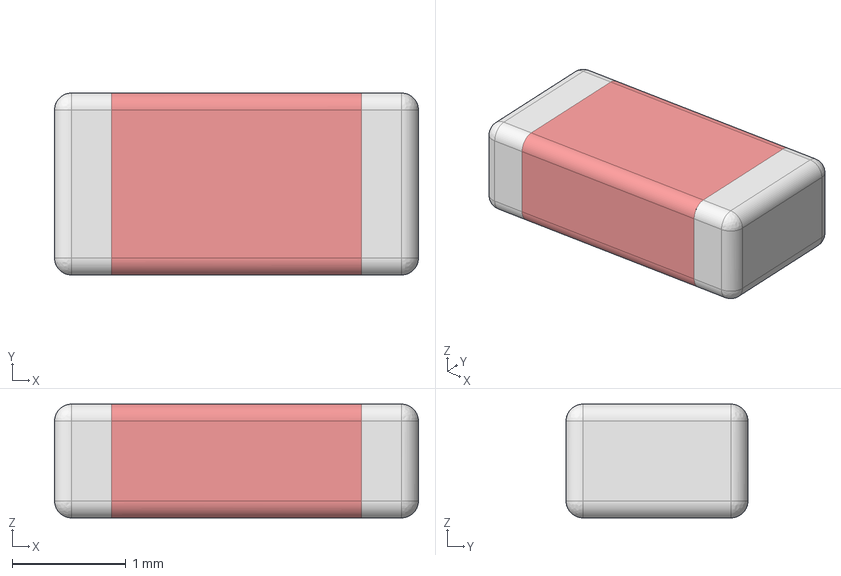
[picture p69: CAD file, 2021-02-06]
3dmodels/capacitor/smd/CAP1206.stp
3.20 x 1.60 x 1.00 mm
