joelvonrotz/KiCAD-Library/3dmodels/Package_QFP/PQFP-112_20x20mm_P0.65mm.step

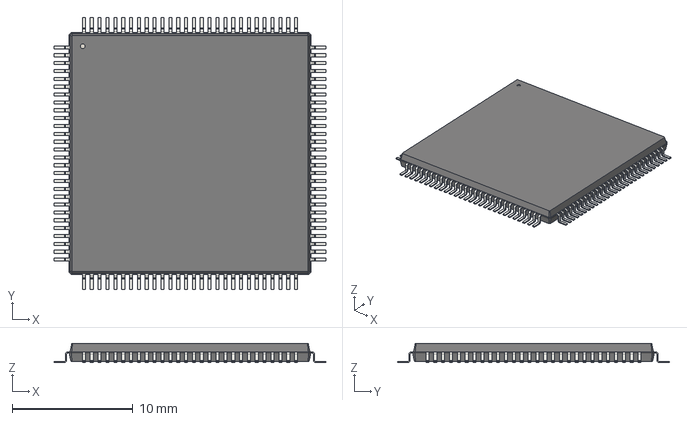
[picture p70: CAD file, 2021-02-06]
3dmodels/Package_QFP/PQFP-112_20x20mm_P0.65mm.step
22.5 x 22.5 x 1.60 mm
