joelvonrotz/KiCAD-Library/3dmodels/Package_SO/TSOP-I-56_18.4x14mm_P0.5mm.step

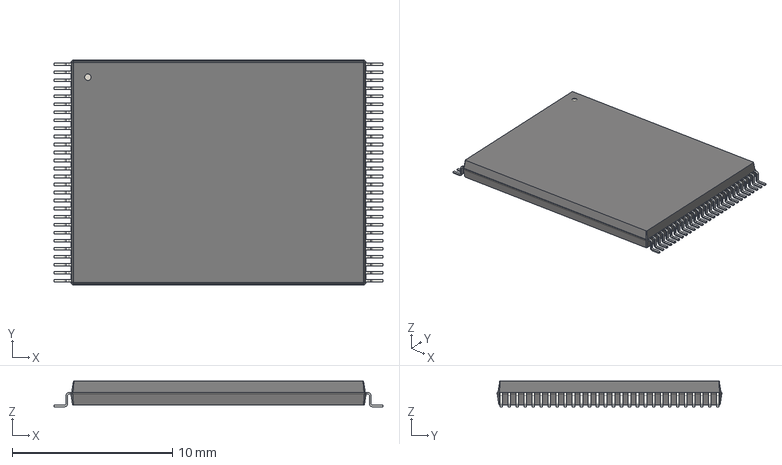
[picture p71: CAD file, 2021-02-06]
3dmodels/Package_SO/TSOP-I-56_18.4x14mm_P0.5mm.step
20.5 x 14.0 x 1.60 mm
