joelvonrotz/KiCAD-Library/3dmodels/resistor/smd/RES1206.stp

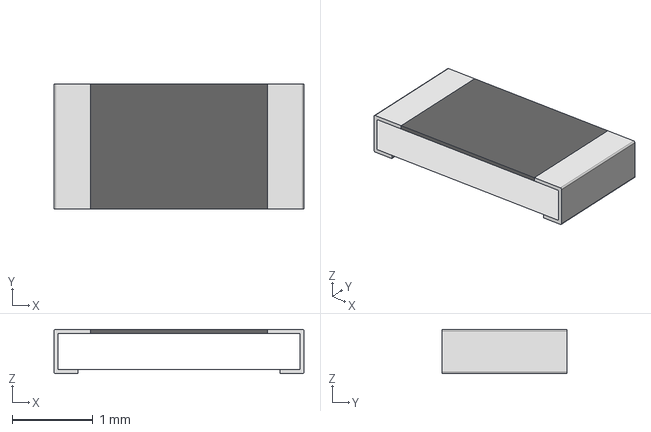
[picture p72: CAD file, 2021-02-06]
3dmodels/resistor/smd/RES1206.stp
3.10 x 1.55 x 0.55 mm
