joelvonrotz/KiCAD-Library/3dmodels/capacitor/smd/CAP0603.stp

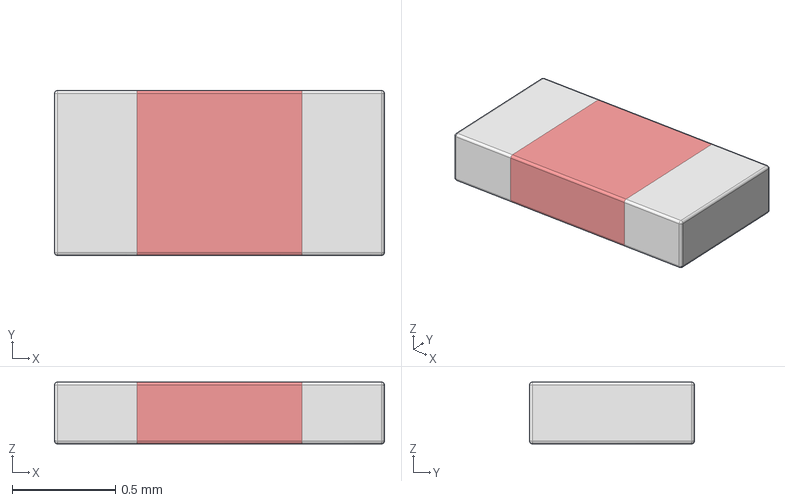
[picture p73: CAD file, 2021-02-06]
3dmodels/capacitor/smd/CAP0603.stp
1.60 x 0.8 x 0.3 mm
