joelvonrotz/KiCAD-Library/3dmodels/Package_SO/SO-20_12.8x7.5mm_P1.27mm.step

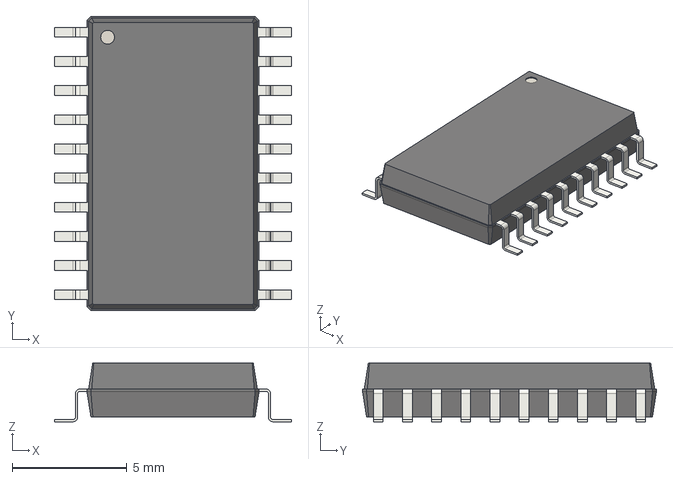
[picture p75: CAD file, 2021-02-06]
3dmodels/Package_SO/SO-20_12.8x7.5mm_P1.27mm.step
10.3 x 12.8 x 2.55 mm
