joelvonrotz/KiCAD-Library/3dmodels/resistor/smd/RES1218.stp

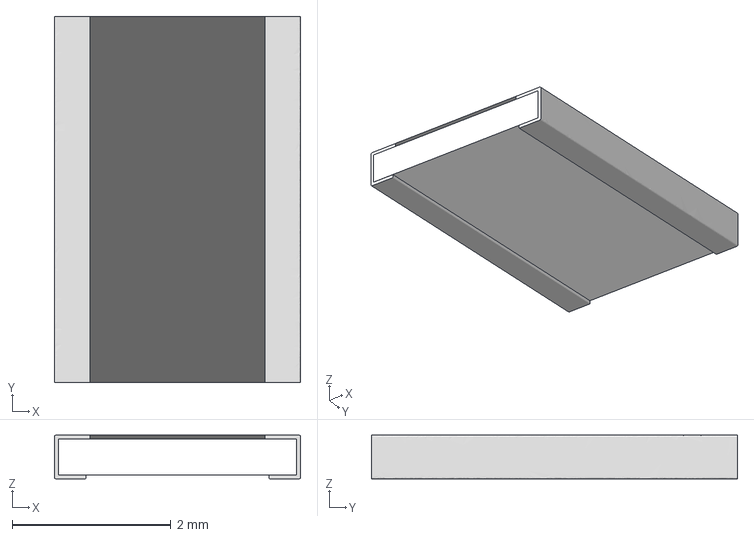
[picture p76: CAD file, 2021-02-06]
3dmodels/resistor/smd/RES1218.stp
3.10 x 4.61 x 0.55 mm
