joelvonrotz/KiCAD-Library/3dmodels/capacitor/smd/CAP1812.stp

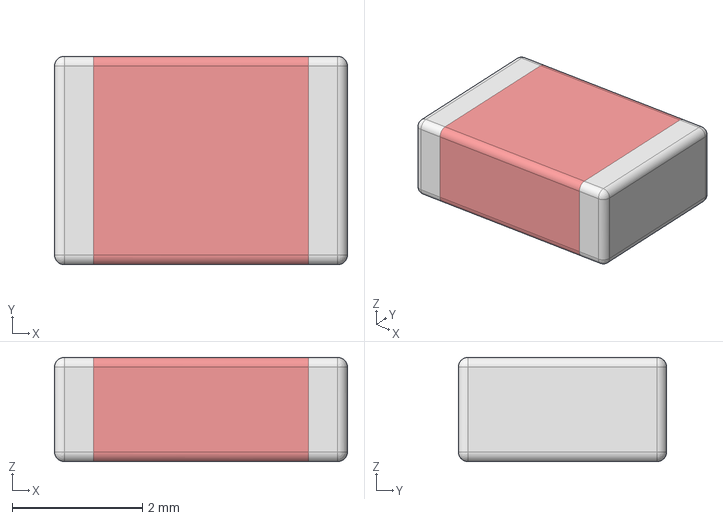
[picture p77: CAD file, 2021-02-06]
3dmodels/capacitor/smd/CAP1812.stp
4.50 x 3.20 x 1.60 mm
