joelvonrotz/KiCAD-Library/3dmodels/Package_QFP/LQFP-64-1EP_10x10mm_P0.5mm_EP6.5x6.5mm.step

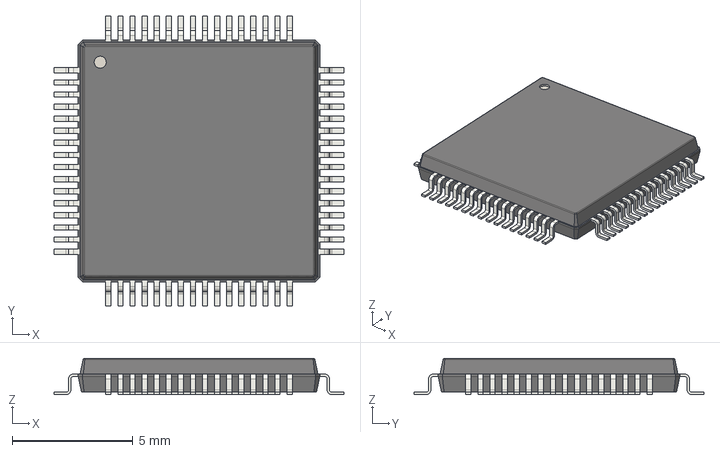
[picture p78: CAD file, 2021-02-06]
3dmodels/Package_QFP/LQFP-64-1EP_10x10mm_P0.5mm_EP6.5x6.5mm.step
12.0 x 12.0 x 1.50 mm
