joelvonrotz/KiCAD-Library/3dmodels/Package_SO/SSOP-56_7.5x18.5mm_P0.635mm.step

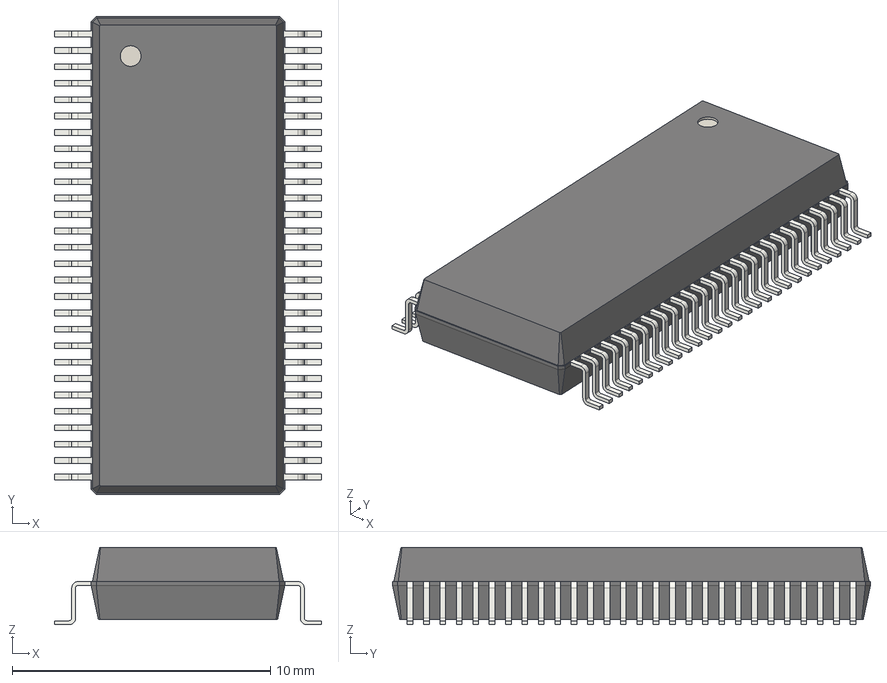
[picture p79: CAD file, 2021-02-06]
3dmodels/Package_SO/SSOP-56_7.5x18.5mm_P0.635mm.step
10.3 x 18.5 x 2.99 mm
