joelvonrotz/KiCAD-Library/3dmodels/resistor/smd/RES2010.stp

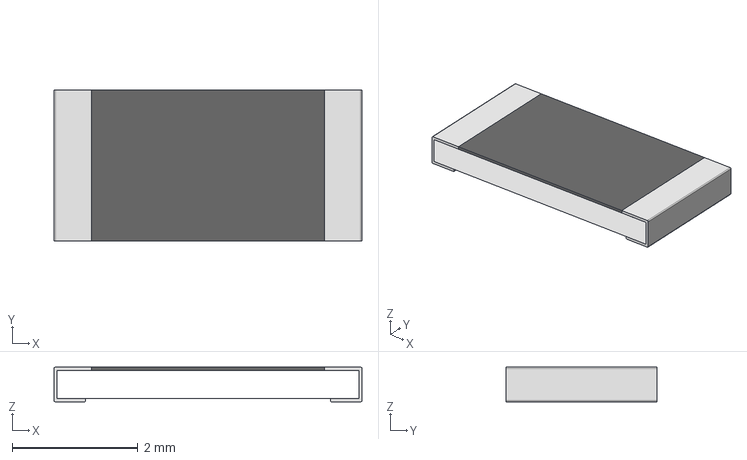
[picture p80: CAD file, 2021-02-06]
3dmodels/resistor/smd/RES2010.stp
4.90 x 2.40 x 0.55 mm
