joelvonrotz/KiCAD-Library/3dmodels/capacitor/smd/CAP1825.stp

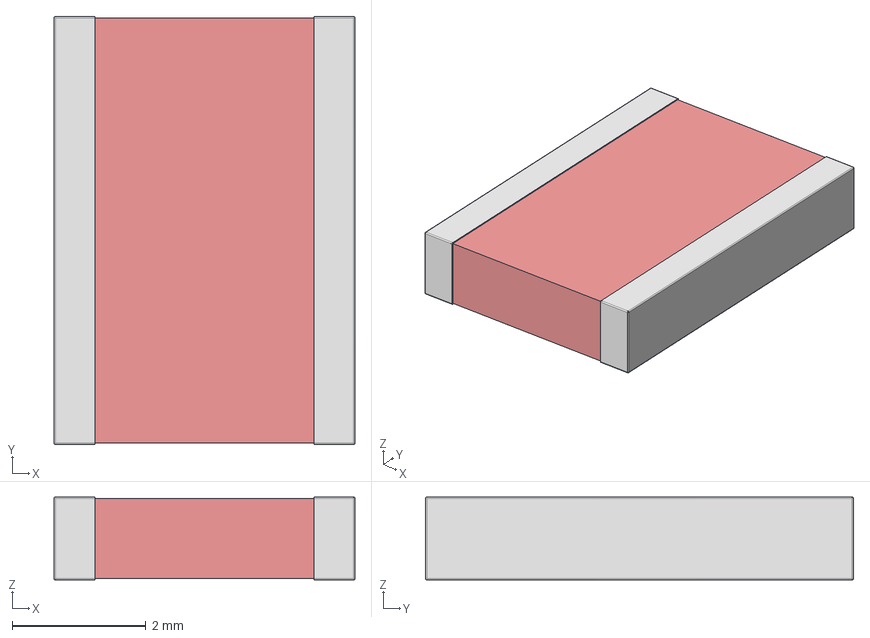
[picture p81: CAD file, 2021-02-06]
3dmodels/capacitor/smd/CAP1825.stp
4.50 x 6.40 x 1.24 mm
