joelvonrotz/KiCAD-Library/3dmodels/Package_QFP/TQFP-64_10x10mm_P0.5mm_EP8x8mm.step

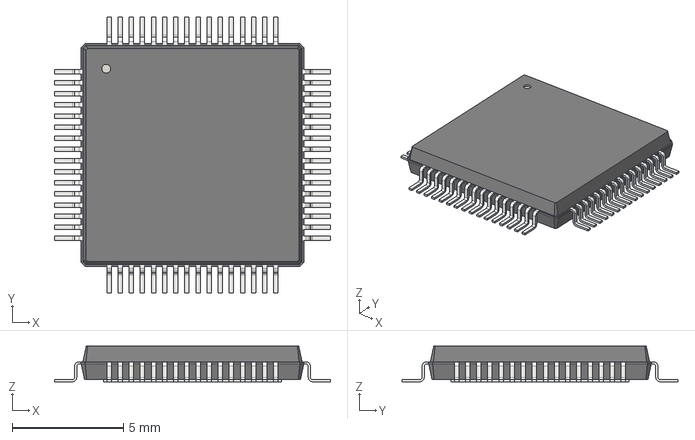
[picture p82: CAD file, 2021-02-06]
3dmodels/Package_QFP/TQFP-64_10x10mm_P0.5mm_EP8x8mm.step
12.4 x 12.4 x 1.60 mm
