joelvonrotz/KiCAD-Library/3dmodels/Package_SO/TSSOP-28_4.4x9.7mm_Pitch0.65mm.step

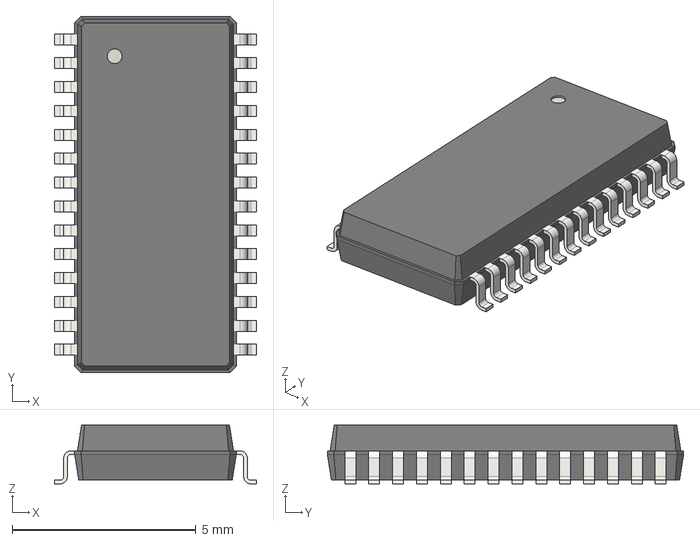
[picture p83: CAD file, 2021-02-06]
3dmodels/Package_SO/TSSOP-28_4.4x9.7mm_Pitch0.65mm.step
5.50 x 9.70 x 1.60 mm
