joelvonrotz/KiCAD-Library/3dmodels/Package_QFP/TQFP-48-1EP_7x7mm_P0.5mm_EP5x5mm.step

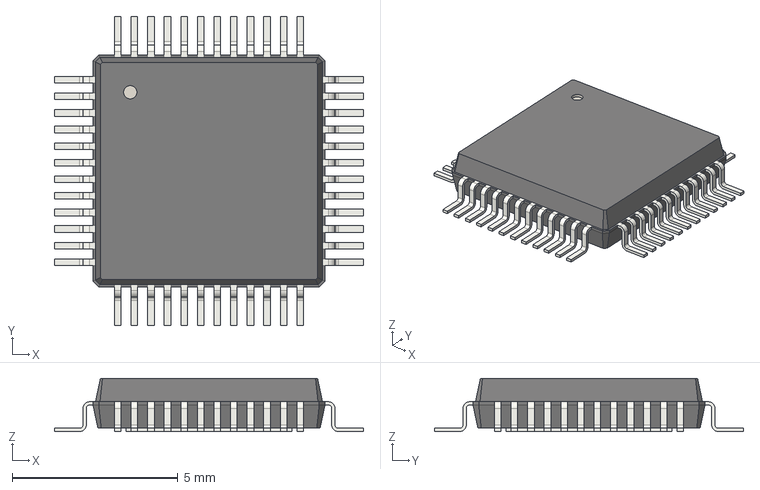
[picture p84: CAD file, 2021-02-06]
3dmodels/Package_QFP/TQFP-48-1EP_7x7mm_P0.5mm_EP5x5mm.step
9.32 x 9.32 x 1.60 mm
