joelvonrotz/KiCAD-Library/3dmodels/Package_SO/SSOP-28_5.3x10.2mm_P0.65mm.step

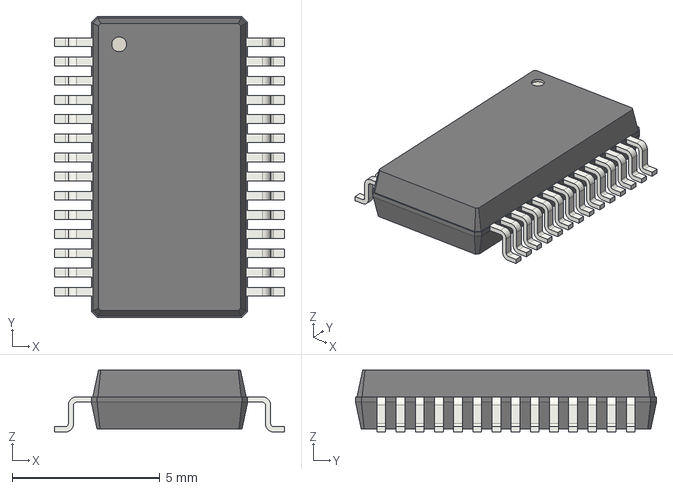
[picture p85: CAD file, 2021-02-06]
3dmodels/Package_SO/SSOP-28_5.3x10.2mm_P0.65mm.step
7.80 x 10.2 x 2.10 mm
