joelvonrotz/KiCAD-Library/3dmodels/Package_SO/TSOP-II-54_22.2x10.16mm_P0.8mm.step

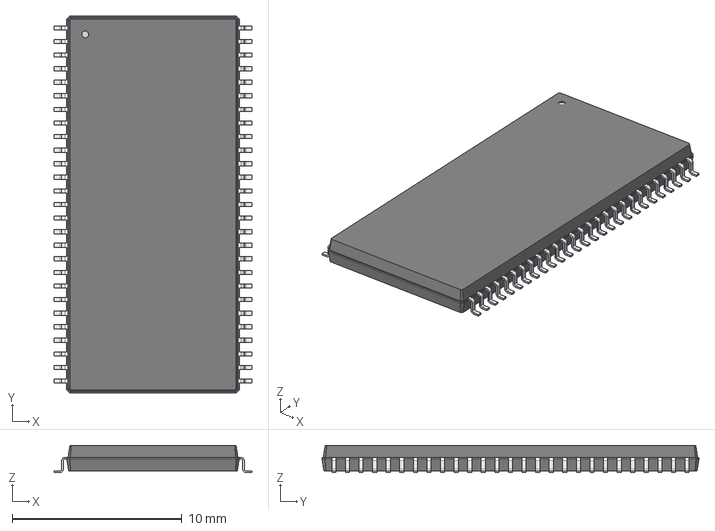
[picture p87: CAD file, 2021-02-06]
3dmodels/Package_SO/TSOP-II-54_22.2x10.16mm_P0.8mm.step
11.7 x 22.2 x 1.60 mm
