joelvonrotz/KiCAD-Library/3dmodels/Package_QFP/LQFP-128_14x14mm_P0.4mm.step

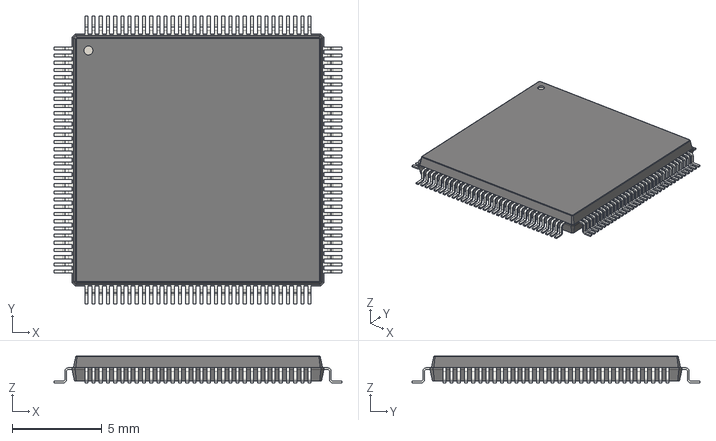
[picture p88: CAD file, 2021-02-06]
3dmodels/Package_QFP/LQFP-128_14x14mm_P0.4mm.step
16.0 x 16.0 x 1.50 mm
