joelvonrotz/KiCAD-Library/3dmodels/Package_SO/SSOP-20_3.9x8.7mm_P0.635mm.step

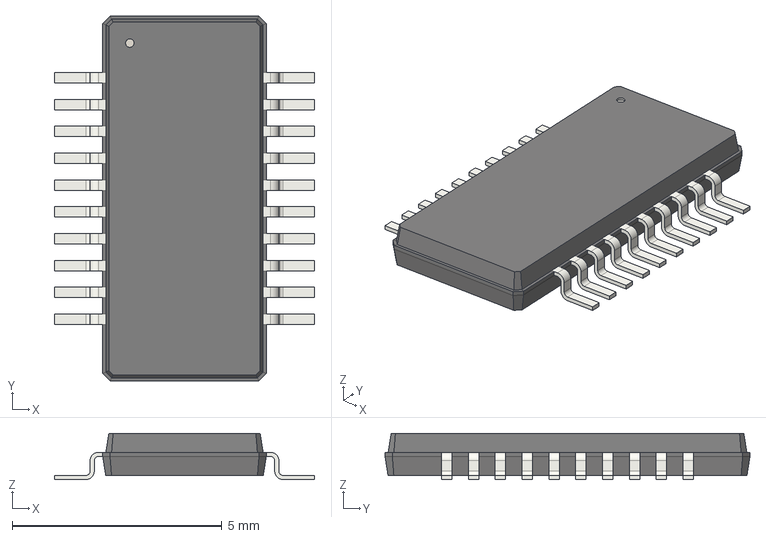
[picture p89: CAD file, 2021-02-06]
3dmodels/Package_SO/SSOP-20_3.9x8.7mm_P0.635mm.step
6.20 x 8.70 x 1.10 mm
