joelvonrotz/KiCAD-Library/3dmodels/Package_QFP/LQFP-44_10x10mm_P0.8mm.step

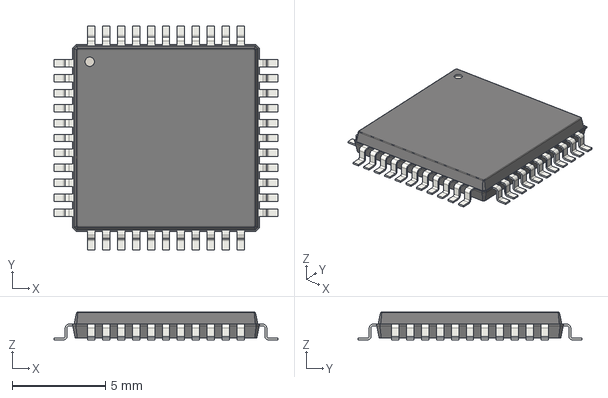
[picture p90: CAD file, 2021-02-06]
3dmodels/Package_QFP/LQFP-44_10x10mm_P0.8mm.step
12.0 x 12.0 x 1.50 mm
