joelvonrotz/KiCAD-Library/3dmodels/Package_SO/MSOP-8-1EP_3x3mm_P0.65mm_EP1.68x1.88mm.step

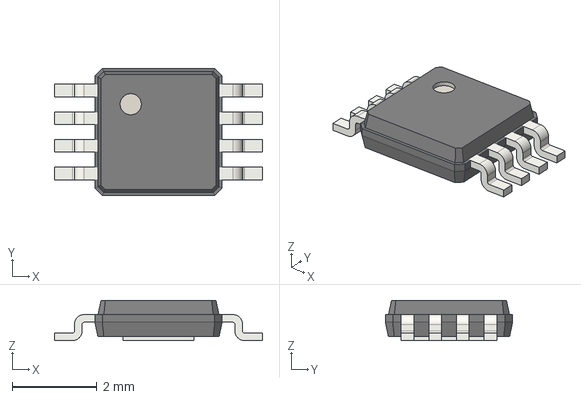
[picture p91: CAD file, 2021-02-06]
3dmodels/Package_SO/MSOP-8-1EP_3x3mm_P0.65mm_EP1.68x1.88mm.step
4.90 x 3.00 x 0.95 mm
