joelvonrotz/KiCAD-Library/3dmodels/Package_SO/SO-4_4.4x4.3mm_P2.54mm.step

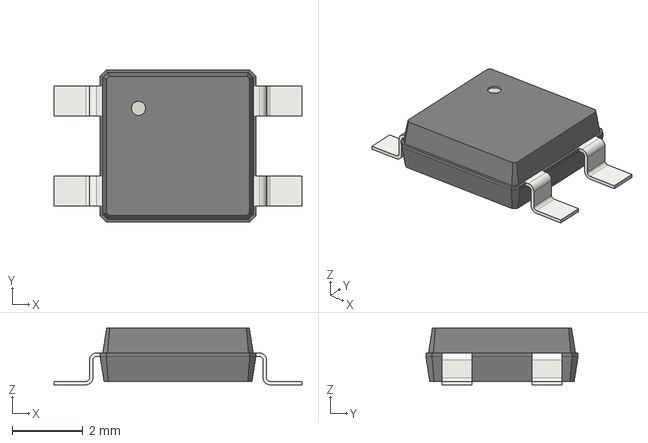
[picture p92: CAD file, 2021-02-06]
3dmodels/Package_SO/SO-4_4.4x4.3mm_P2.54mm.step
7.00 x 4.30 x 1.60 mm
