joelvonrotz/KiCAD-Library/3dmodels/Package_QFP/PQFP-132_24x24mm_P0.635mm.step

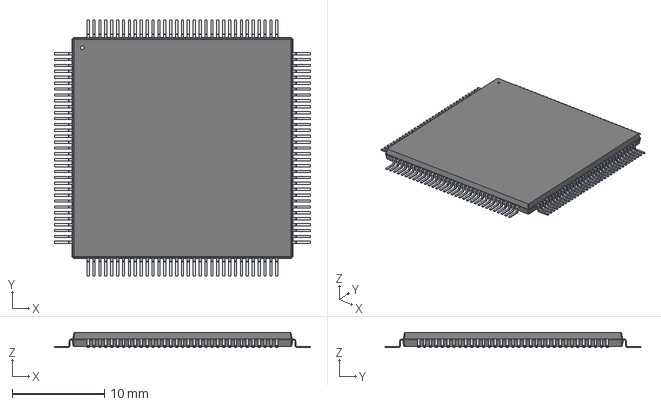
[picture p93: CAD file, 2021-02-06]
3dmodels/Package_QFP/PQFP-132_24x24mm_P0.635mm.step
27.8 x 27.8 x 1.60 mm
