joelvonrotz/KiCAD-Library/3dmodels/Package_SO/TSSOP-64_6.1x17mm_P0.5mm.step

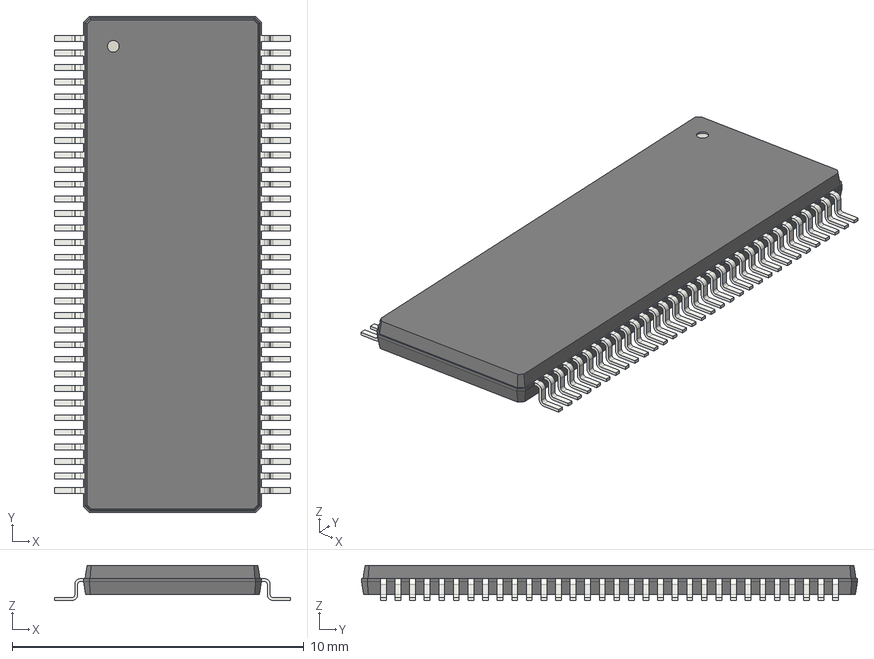
[picture p94: CAD file, 2021-02-06]
3dmodels/Package_SO/TSSOP-64_6.1x17mm_P0.5mm.step
8.10 x 17.0 x 1.20 mm
