joelvonrotz/KiCAD-Library/3dmodels/Package_QFP/LQFP-36_7x7mm_P0.65mm.step

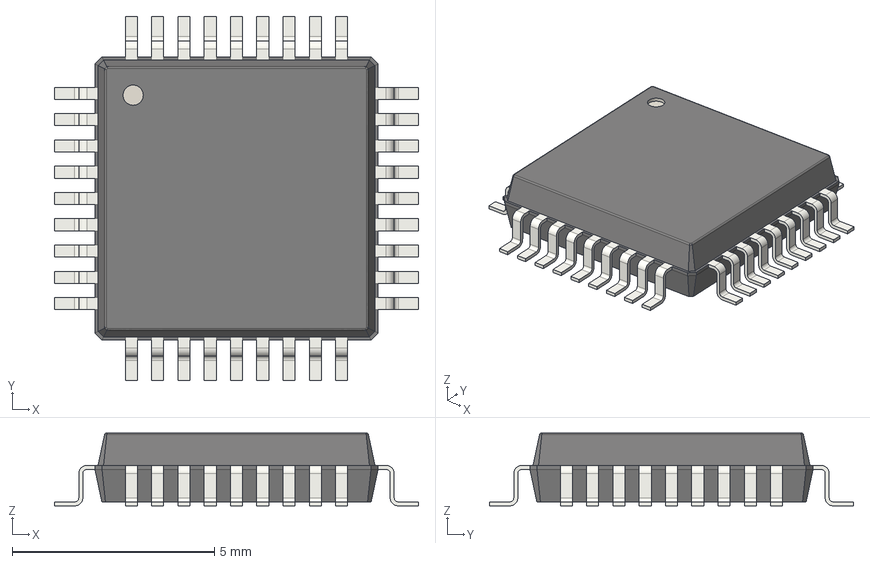
[picture p97: CAD file, 2021-02-06]
3dmodels/Package_QFP/LQFP-36_7x7mm_P0.65mm.step
9.00 x 9.00 x 1.80 mm
