joelvonrotz/KiCAD-Library/3dmodels/Package_QFP/TQFP-144_16x16mm_P0.4mm.step

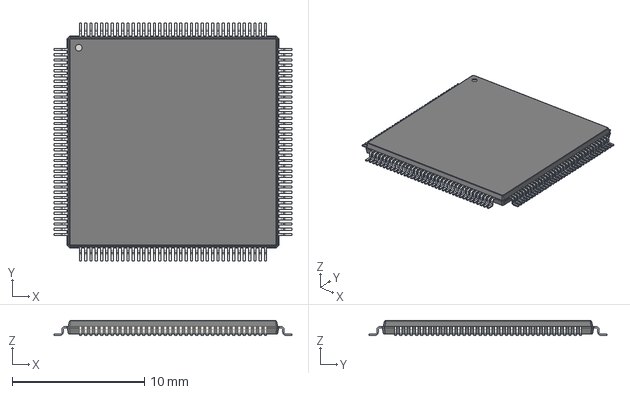
[picture p98: CAD file, 2021-02-06]
3dmodels/Package_QFP/TQFP-144_16x16mm_P0.4mm.step
18.0 x 18.0 x 1.10 mm
