joelvonrotz/KiCAD-Library/3dmodels/Package_SO/TSSOP-50_4.4x12.5mm_P0.5mm.step

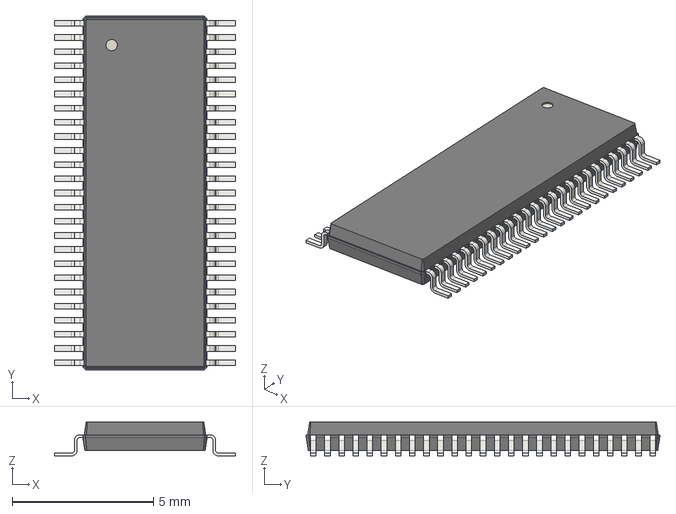
[picture p99: CAD file, 2021-02-06]
3dmodels/Package_SO/TSSOP-50_4.4x12.5mm_P0.5mm.step
6.40 x 12.5 x 1.20 mm
