joelvonrotz/KiCAD-Library/3dmodels/Package_QFP/LQFP-64_7x7mm_P0.4mm.step

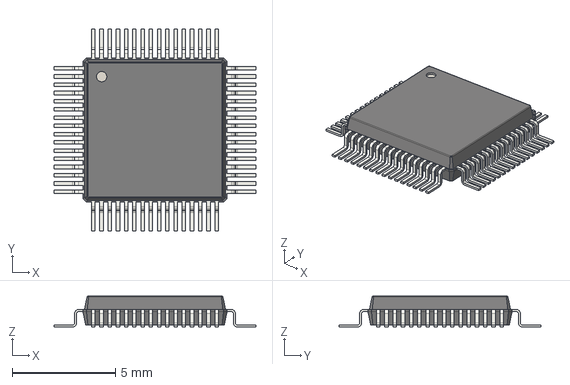
[picture p100: CAD file, 2021-02-06]
3dmodels/Package_QFP/LQFP-64_7x7mm_P0.4mm.step
9.80 x 9.80 x 1.50 mm
