joelvonrotz/KiCAD-Library/3dmodels/Package_SO/TI_SO-PowerPAD-8.step

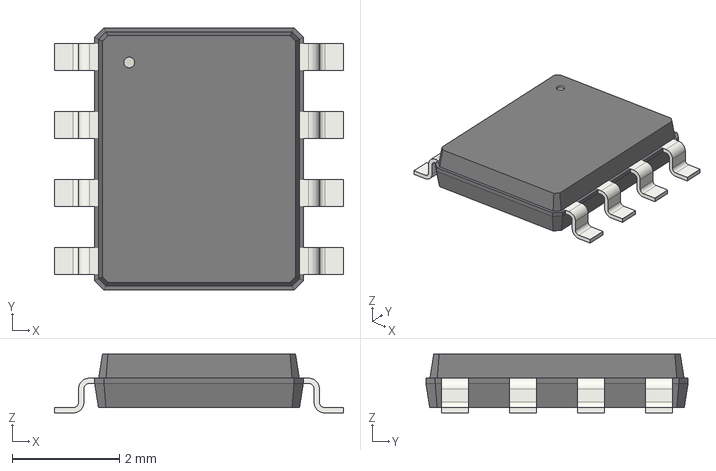
[picture p101: CAD file, 2021-02-06]
3dmodels/Package_SO/TI_SO-PowerPAD-8.step
5.40 x 4.90 x 1.10 mm
