joelvonrotz/KiCAD-Library/3dmodels/Package_QFP/PQFP-80_14x20mm_P0.8mm.step

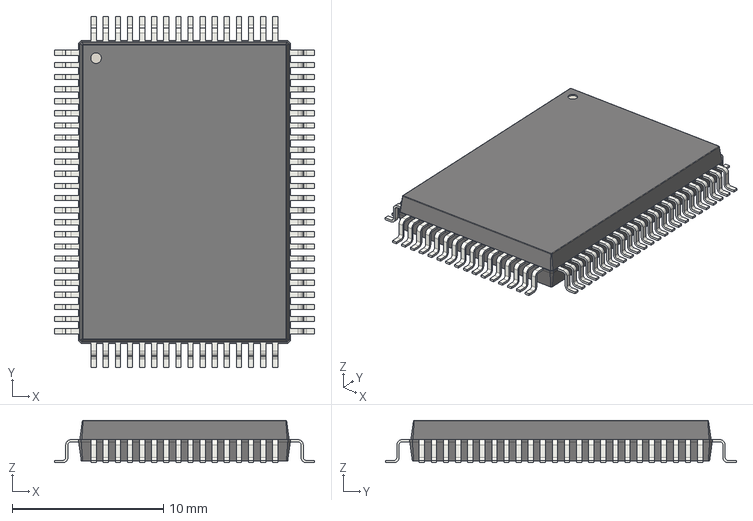
[picture p102: CAD file, 2021-02-06]
3dmodels/Package_QFP/PQFP-80_14x20mm_P0.8mm.step
17.2 x 23.2 x 2.80 mm
