joelvonrotz/KiCAD-Library/3dmodels/Package_SO/SSO-4_6.7x5.1mm_P2.54mm_Clearance8mm.step

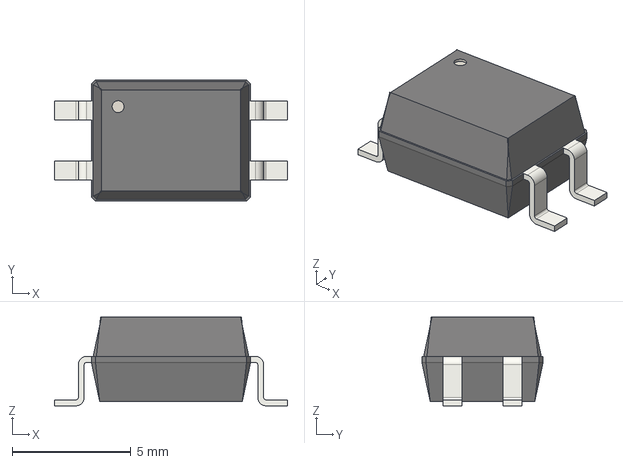
[picture p103: CAD file, 2021-02-06]
3dmodels/Package_SO/SSO-4_6.7x5.1mm_P2.54mm_Clearance8mm.step
9.80 x 5.10 x 3.73 mm
