joelvonrotz/KiCAD-Library/3dmodels/Package_SO/HSOP-8-1EP_3.9x4.9mm_P1.27mm_EP2.41x3.1mm.step

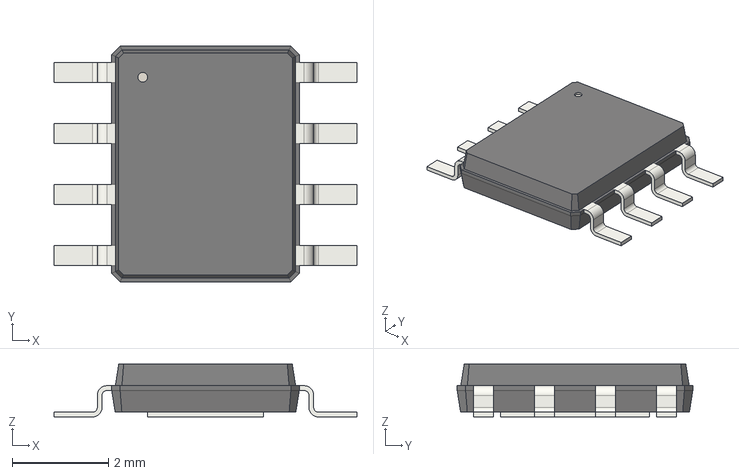
[picture p104: CAD file, 2021-02-06]
3dmodels/Package_SO/HSOP-8-1EP_3.9x4.9mm_P1.27mm_EP2.41x3.1mm.step
6.30 x 4.90 x 1.10 mm
