joelvonrotz/KiCAD-Library/3dmodels/Package_SO/TSSOP-24_4.4x5mm_P0.4mm.step

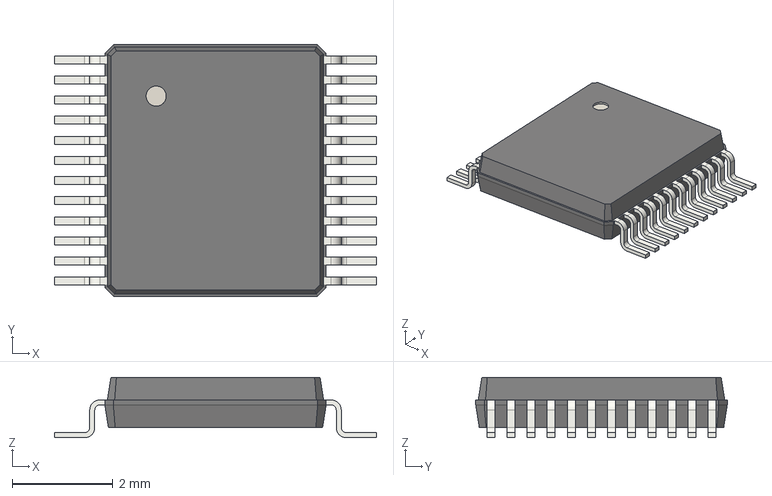
[picture p105: CAD file, 2021-02-06]
3dmodels/Package_SO/TSSOP-24_4.4x5mm_P0.4mm.step
6.40 x 5.00 x 1.20 mm
