joelvonrotz/KiCAD-Library/3dmodels/Package_SO/SSO-8_9.6x6.3mm_P1.27mm_Clearance10.5mm.step

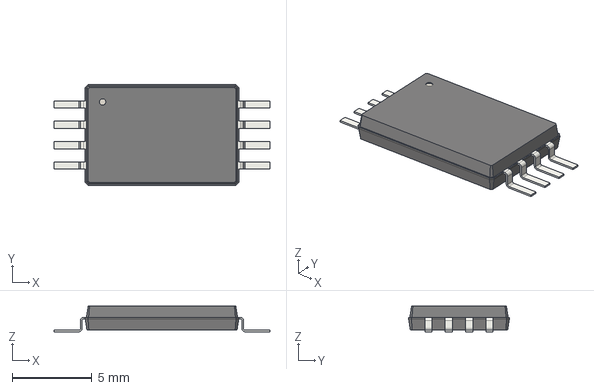
[picture p106: CAD file, 2021-02-06]
3dmodels/Package_SO/SSO-8_9.6x6.3mm_P1.27mm_Clearance10.5mm.step
13.5 x 6.30 x 1.60 mm
