joelvonrotz/KiCAD-Library/3dmodels/Package_QFP/TQFP-48-1EP_7x7mm_P0.5mm_EP3.5x3.5mm.step

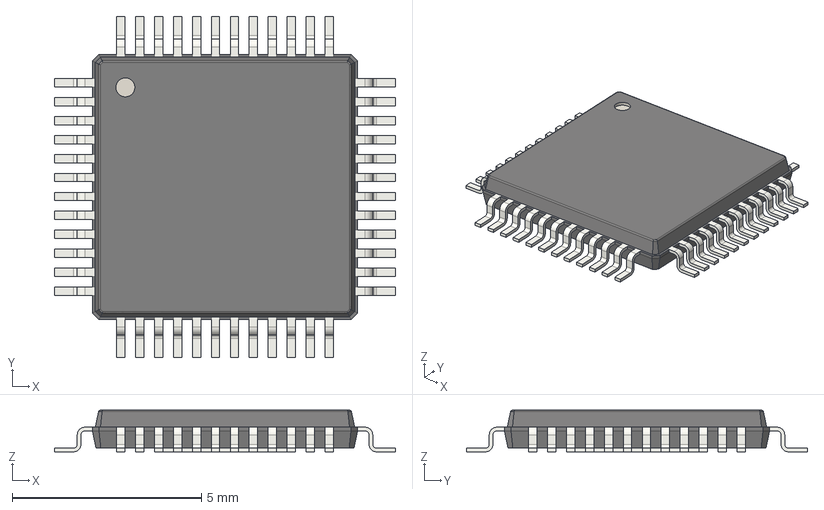
[picture p107: CAD file, 2021-02-06]
3dmodels/Package_QFP/TQFP-48-1EP_7x7mm_P0.5mm_EP3.5x3.5mm.step
9.00 x 9.00 x 1.10 mm
