joelvonrotz/KiCAD-Library/3dmodels/Package_SO/QSOP-24_3.9x8.7mm_P0.635mm.step

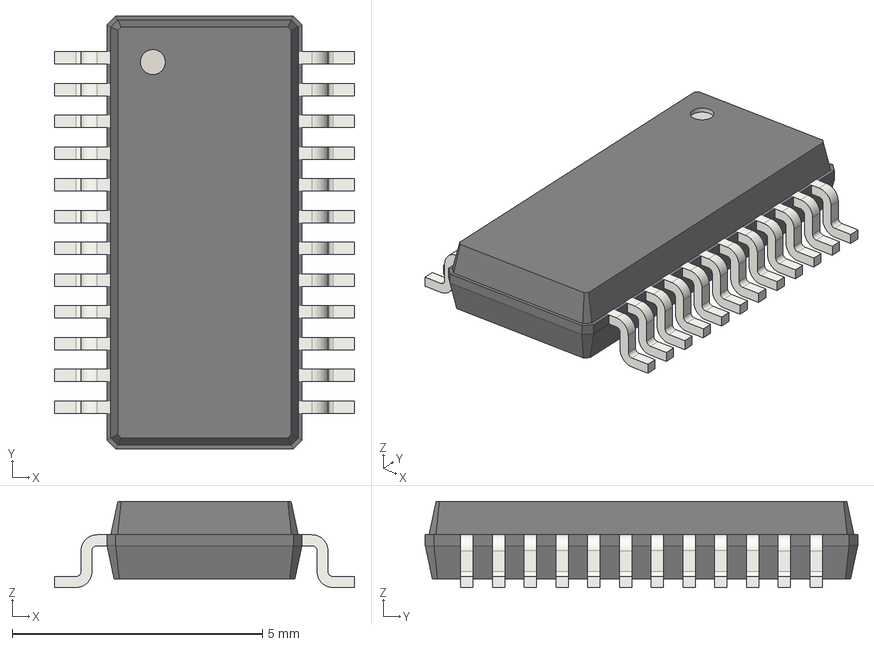
[picture p108: CAD file, 2021-02-06]
3dmodels/Package_SO/QSOP-24_3.9x8.7mm_P0.635mm.step
6.00 x 8.65 x 1.72 mm
