joelvonrotz/KiCAD-Library/3dmodels/Package_SO/TSOP-6_1.65x3.05mm_P0.95mm.step

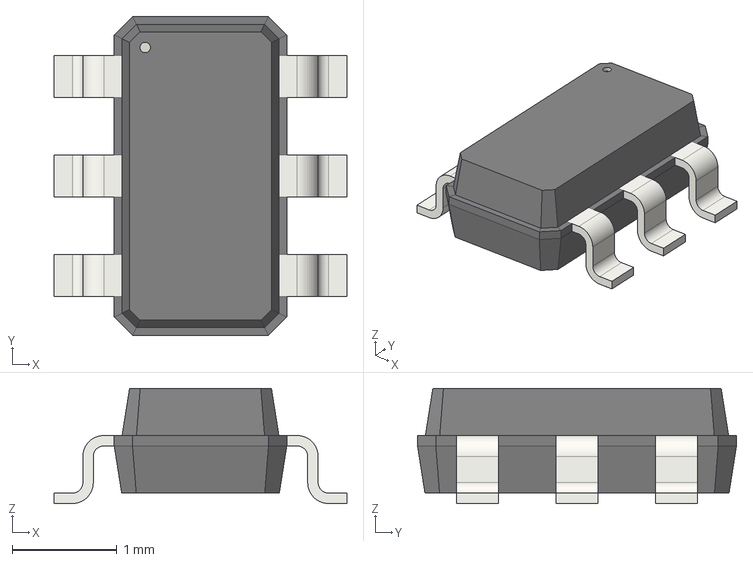
[picture p110: CAD file, 2021-02-06]
3dmodels/Package_SO/TSOP-6_1.65x3.05mm_P0.95mm.step
2.80 x 3.05 x 1.10 mm
