joelvonrotz/KiCAD-Library/3dmodels/Package_SO/SOIC-24W_7.5x15.4mm_P1.27mm.step

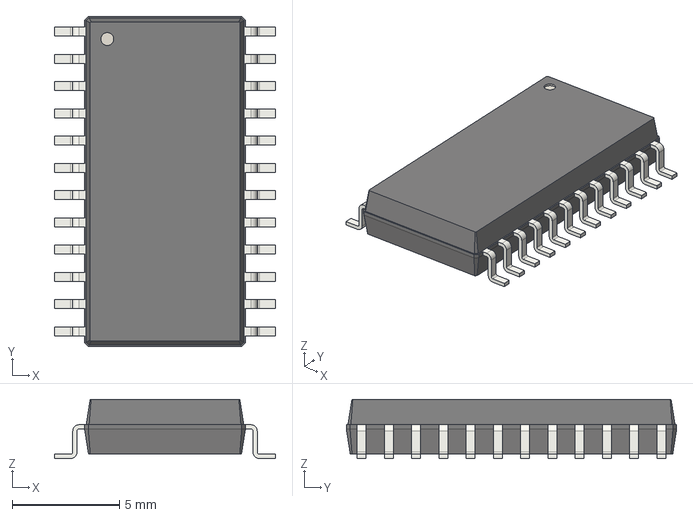
[picture p111: CAD file, 2021-02-06]
3dmodels/Package_SO/SOIC-24W_7.5x15.4mm_P1.27mm.step
10.3 x 15.4 x 2.75 mm
