joelvonrotz/KiCAD-Library/3dmodels/Package_SO/TSSOP-48_6.1x12.5mm_P0.5mm.step

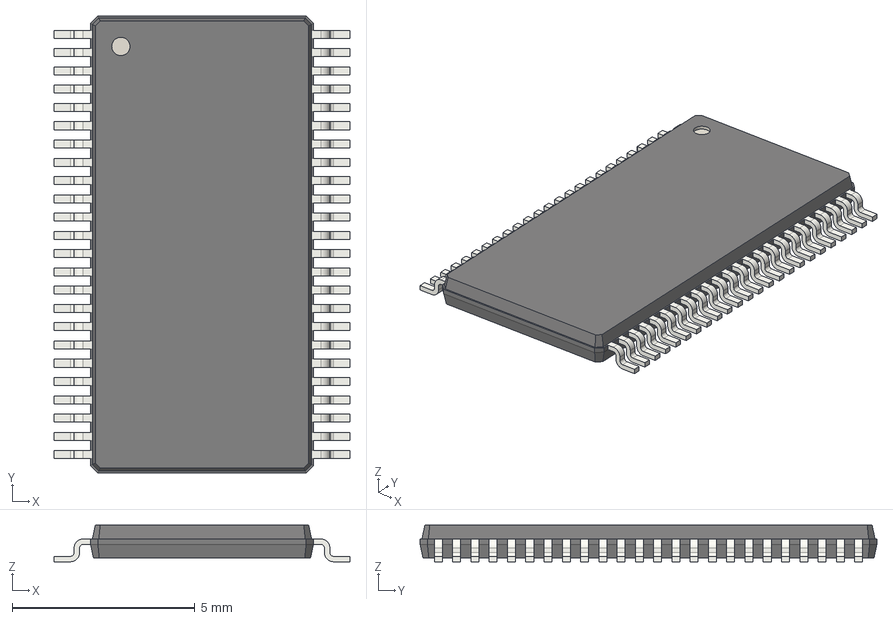
[picture p113: CAD file, 2021-02-06]
3dmodels/Package_SO/TSSOP-48_6.1x12.5mm_P0.5mm.step
8.10 x 12.5 x 1 mm
