joelvonrotz/KiCAD-Library/3dmodels/Package_QFP/PQFP-144_28x28mm_P0.65mm.step

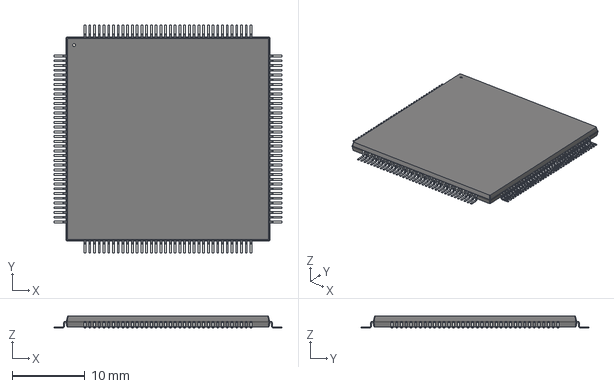
[picture p115: CAD file, 2021-02-06]
3dmodels/Package_QFP/PQFP-144_28x28mm_P0.65mm.step
31.2 x 31.2 x 1.60 mm
