joelvonrotz/KiCAD-Library/3dmodels/Package_SO/SOIC-16_3.9x9.9mm_P1.27mm.step

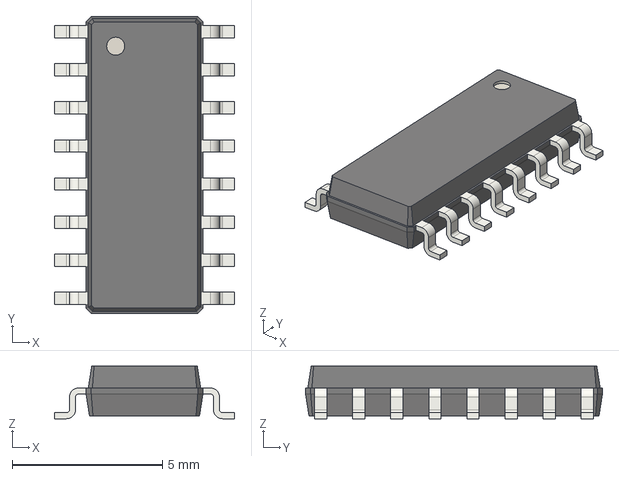
[picture p116: CAD file, 2021-02-06]
3dmodels/Package_SO/SOIC-16_3.9x9.9mm_P1.27mm.step
6.00 x 9.90 x 1.75 mm
