joelvonrotz/KiCAD-Library/3dmodels/Package_QFP/TQFP-44-1EP_10x10mm_P0.8mm_EP4.5x4.5mm.step

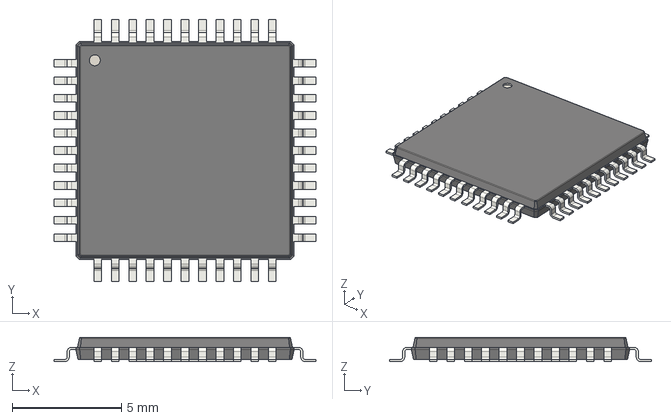
[picture p117: CAD file, 2021-02-06]
3dmodels/Package_QFP/TQFP-44-1EP_10x10mm_P0.8mm_EP4.5x4.5mm.step
12.0 x 12.0 x 1.10 mm
