joelvonrotz/KiCAD-Library/3dmodels/Package_SO/TSSOP-16-1EP_4.4x5mm_P0.65mm.step

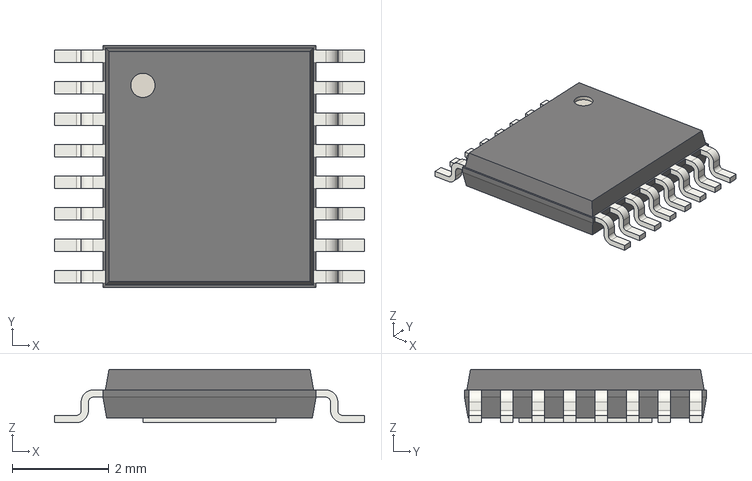
[picture p118: CAD file, 2021-02-06]
3dmodels/Package_SO/TSSOP-16-1EP_4.4x5mm_P0.65mm.step
6.40 x 5.00 x 1.10 mm
