joelvonrotz/KiCAD-Library/3dmodels/Package_QFP/TQFP-100_12x12mm_P0.4mm.step

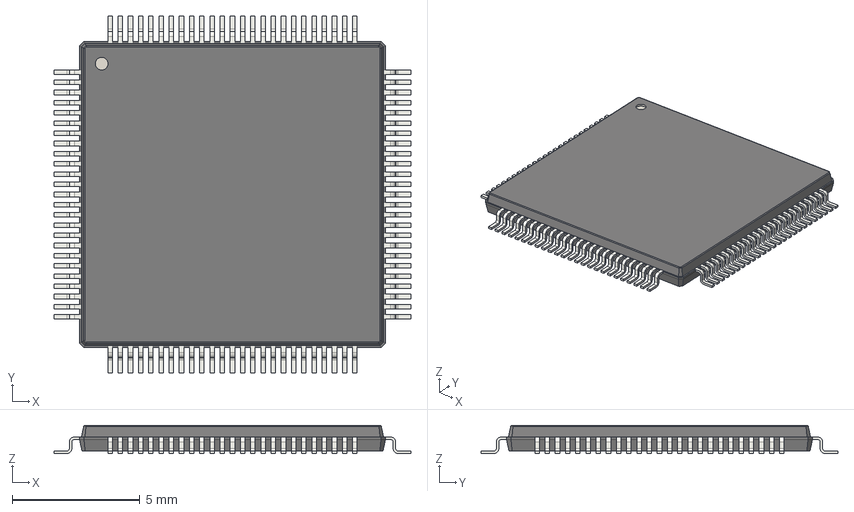
[picture p119: CAD file, 2021-02-06]
3dmodels/Package_QFP/TQFP-100_12x12mm_P0.4mm.step
14.0 x 14.0 x 1.10 mm
