joelvonrotz/KiCAD-Library/3dmodels/Package_SO/SO-4_4.4x3.6mm_P2.54mm.step

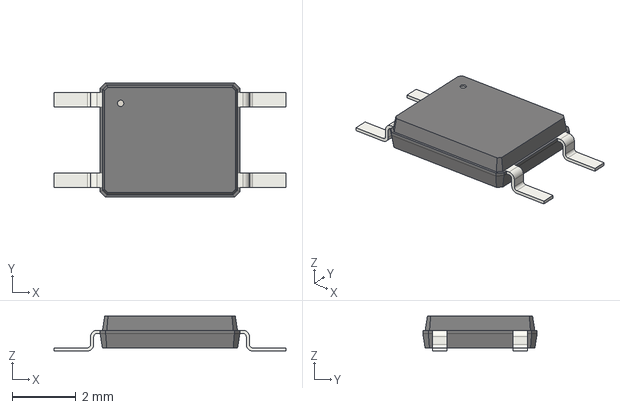
[picture p120: CAD file, 2021-02-06]
3dmodels/Package_SO/SO-4_4.4x3.6mm_P2.54mm.step
7.30 x 3.60 x 1.10 mm
