joelvonrotz/KiCAD-Library/3dmodels/Package_QFP/LQFP-80_12x12mm_P0.5mm.step

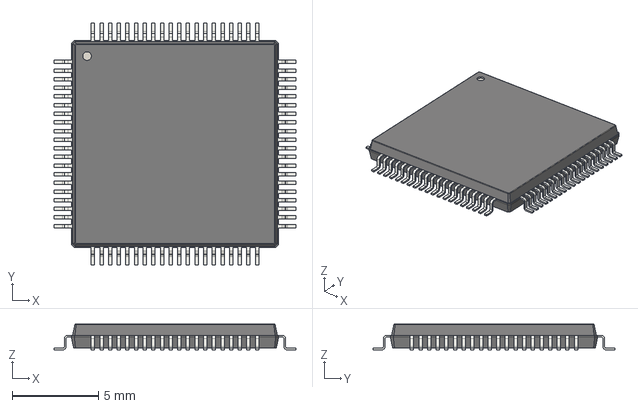
[picture p121: CAD file, 2021-02-06]
3dmodels/Package_QFP/LQFP-80_12x12mm_P0.5mm.step
14.0 x 14.0 x 1.50 mm
