joelvonrotz/KiCAD-Library/3dmodels/Package_SO/QSOP-20_3.9x8.7mm_P0.635mm.step

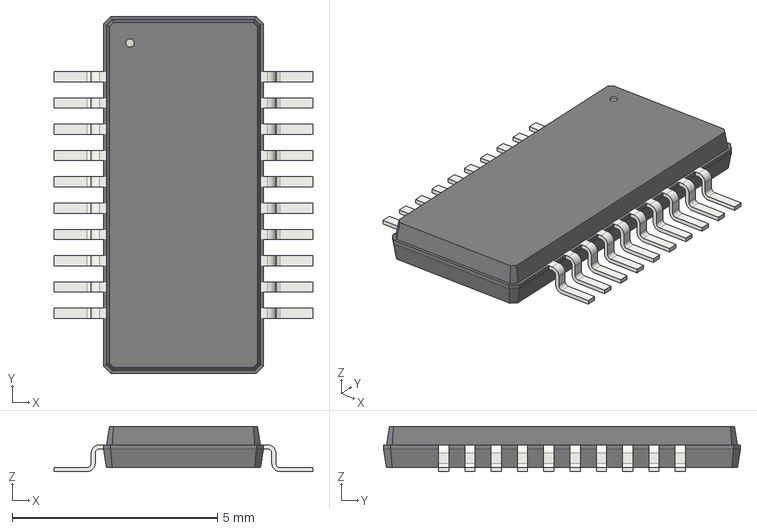
[picture p123: CAD file, 2021-02-06]
3dmodels/Package_SO/QSOP-20_3.9x8.7mm_P0.635mm.step
6.31 x 8.70 x 1.10 mm
