joelvonrotz/KiCAD-Library/3dmodels/Package_SO/PowerIntegrations_SO-8B.step

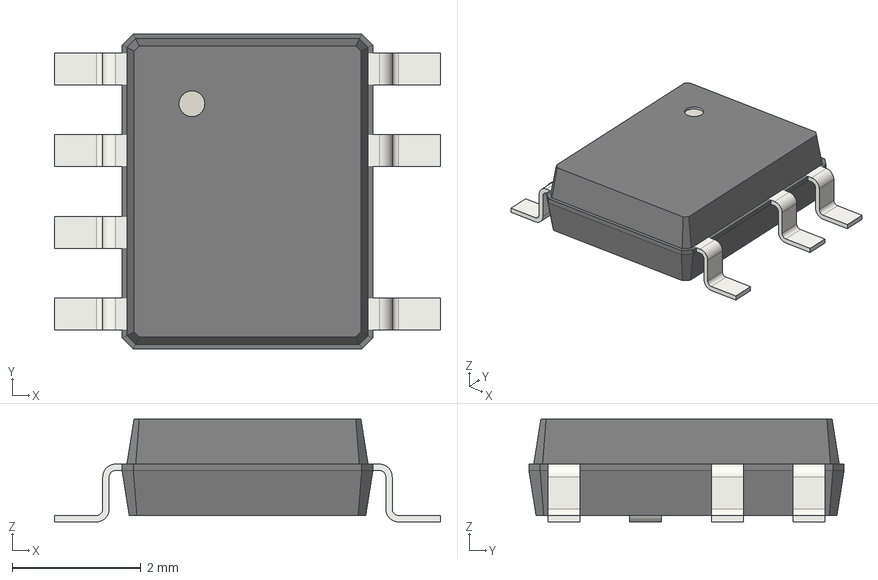
[picture p124: CAD file, 2021-02-06]
3dmodels/Package_SO/PowerIntegrations_SO-8B.step
6.00 x 4.90 x 1.60 mm
