joelvonrotz/KiCAD-Library/3dmodels/Package_SO/ST_PowerSSO-24_SlugUp.step

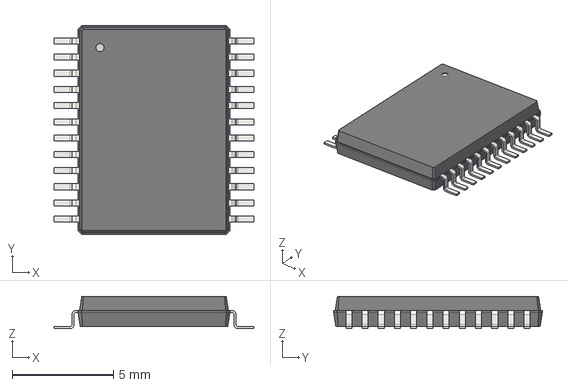
[picture p125: CAD file, 2021-02-06]
3dmodels/Package_SO/ST_PowerSSO-24_SlugUp.step
9.87 x 10.3 x 1.60 mm
