joelvonrotz/KiCAD-Library/3dmodels/Package_QFP/LQFP-100_14x14mm_P0.5mm.step

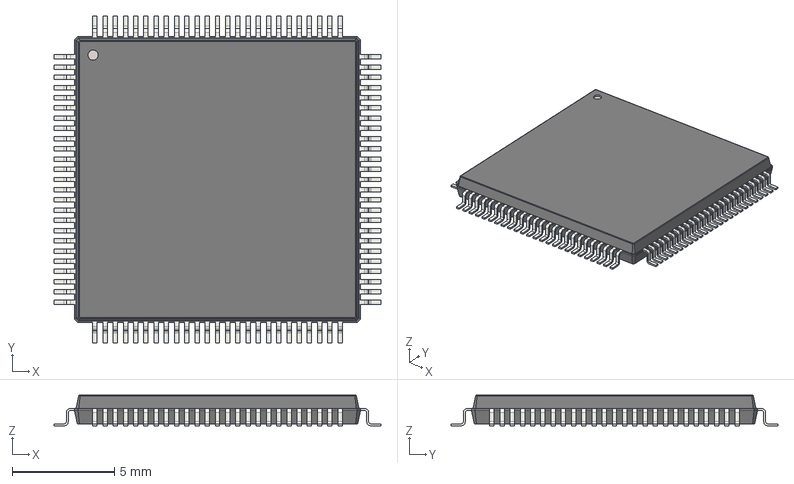
[picture p126: CAD file, 2021-02-06]
3dmodels/Package_QFP/LQFP-100_14x14mm_P0.5mm.step
16.0 x 16.0 x 1.50 mm
