joelvonrotz/KiCAD-Library/3dmodels/Package_QFP/PQFP-100_14x20mm_P0.65mm.step

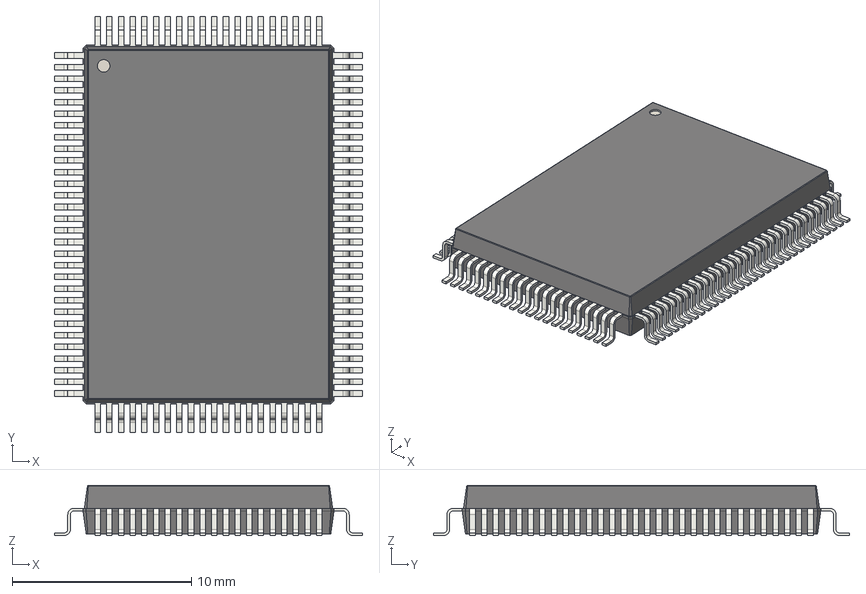
[picture p128: CAD file, 2021-02-06]
3dmodels/Package_QFP/PQFP-100_14x20mm_P0.65mm.step
17.2 x 23.2 x 2.80 mm
