joelvonrotz/KiCAD-Library/3dmodels/Package_SO/TSSOP-48_4.4x9.7mm_P0.4mm.step

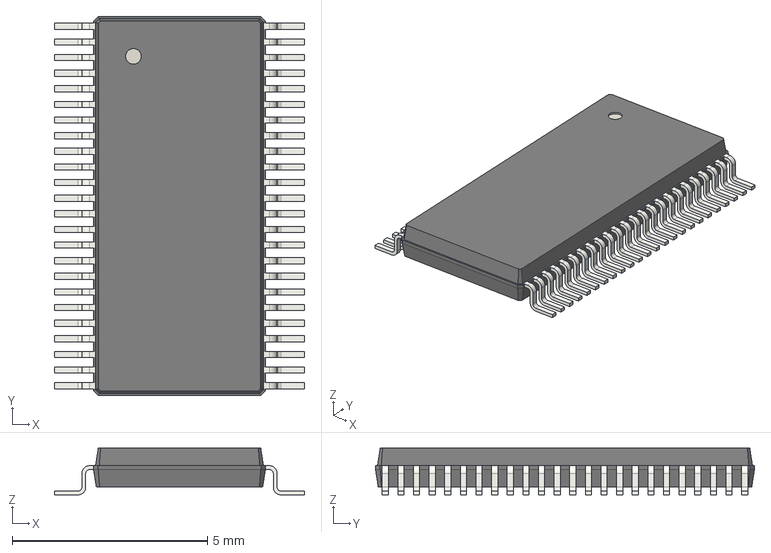
[picture p129: CAD file, 2021-02-06]
3dmodels/Package_SO/TSSOP-48_4.4x9.7mm_P0.4mm.step
6.40 x 9.70 x 1.20 mm
