joelvonrotz/KiCAD-Library/3dmodels/Package_QFP/LQFP-32-1EP_5x5mm_P0.5mm_EP3.45x3.45mm_EP3.45x3.45mm.step

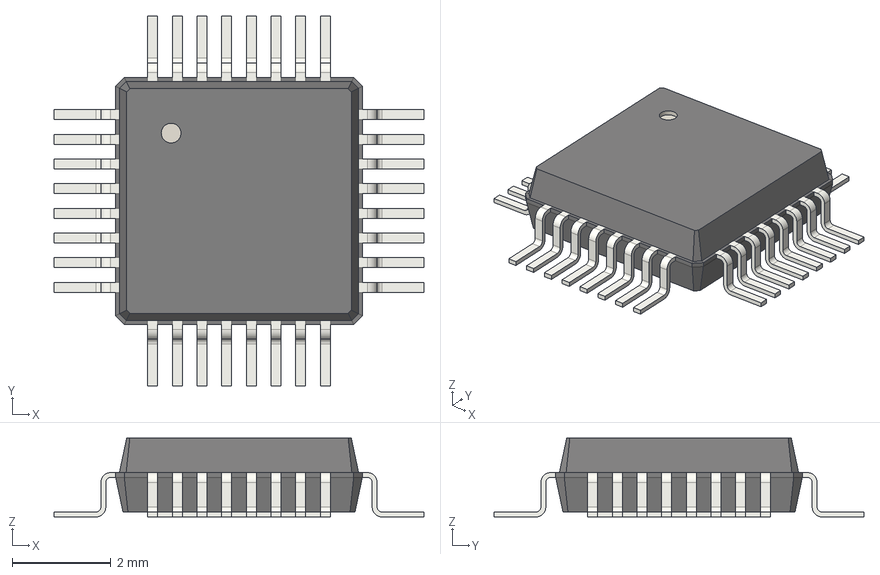
[picture p130: CAD file, 2021-02-06]
3dmodels/Package_QFP/LQFP-32-1EP_5x5mm_P0.5mm_EP3.45x3.45mm_EP3.45x3.45mm.step
7.50 x 7.50 x 1.60 mm
