joelvonrotz/KiCAD-Library/3dmodels/Package_SO/TSSOP-56_6.1x12.5mm_P0.4mm.step

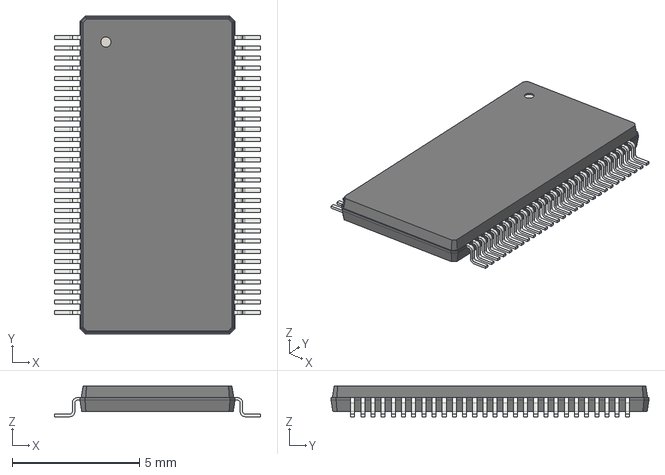
[picture p131: CAD file, 2021-02-06]
3dmodels/Package_SO/TSSOP-56_6.1x12.5mm_P0.4mm.step
8.10 x 12.5 x 1.20 mm
