joelvonrotz/KiCAD-Library/3dmodels/Package_QFP/VQFP-128_14x14mm_P0.4mm.step

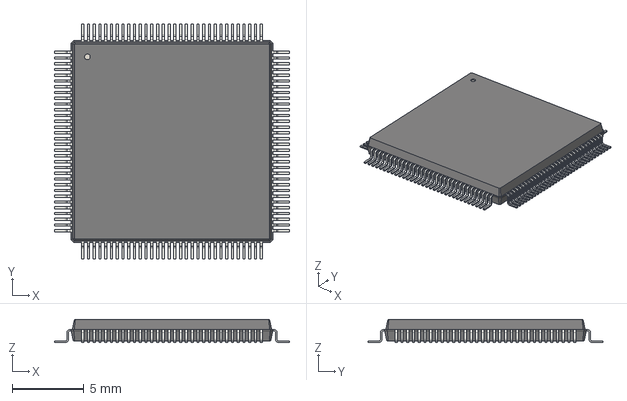
[picture p132: CAD file, 2021-02-06]
3dmodels/Package_QFP/VQFP-128_14x14mm_P0.4mm.step
16.3 x 16.3 x 1.60 mm
