joelvonrotz/KiCAD-Library/3dmodels/Package_SO/MSOP-12-16_3x4mm_P0.5mm.step

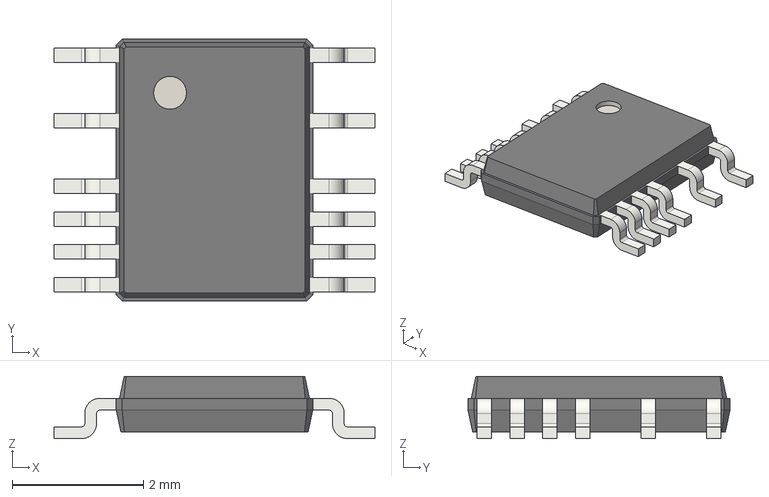
[picture p133: CAD file, 2021-02-06]
3dmodels/Package_SO/MSOP-12-16_3x4mm_P0.5mm.step
4.90 x 4.00 x 0.95 mm
