joelvonrotz/KiCAD-Library/3dmodels/Package_SO/SSOP-8_3.9x5.05mm_P1.27mm.step

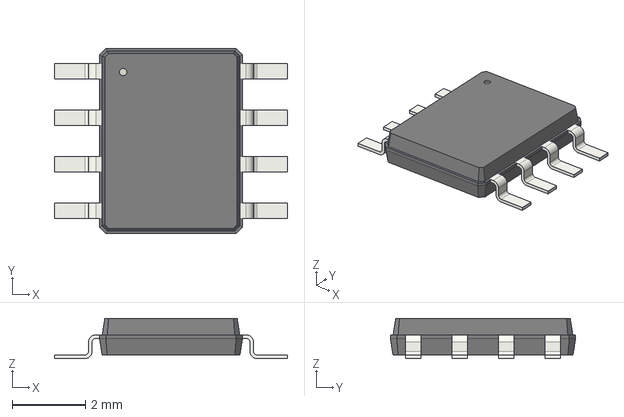
[picture p134: CAD file, 2021-02-06]
3dmodels/Package_SO/SSOP-8_3.9x5.05mm_P1.27mm.step
6.35 x 5.05 x 1.10 mm
