joelvonrotz/KiCAD-Library/3dmodels/Package_SO/SO-6_4.4x3.6mm_P1.27mm.step

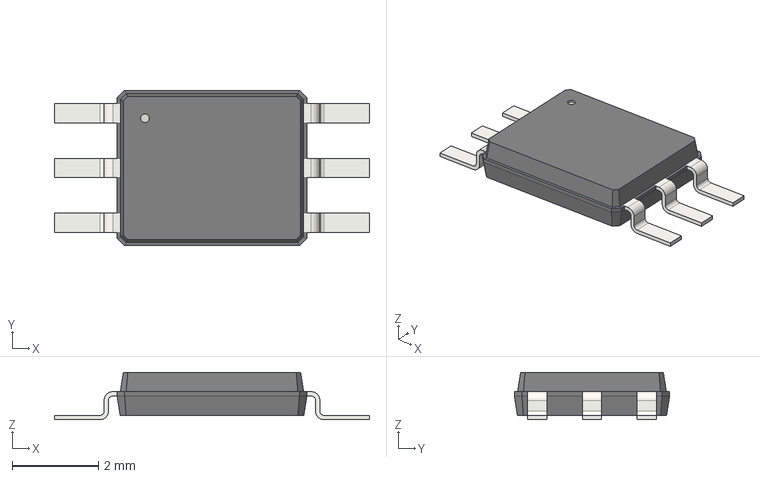
[picture p135: CAD file, 2021-02-06]
3dmodels/Package_SO/SO-6_4.4x3.6mm_P1.27mm.step
7.30 x 3.60 x 1.10 mm
