joelvonrotz/KiCAD-Library/3dmodels/Package_SO/TSSOP-56_8x14mm_P0.5mm.step

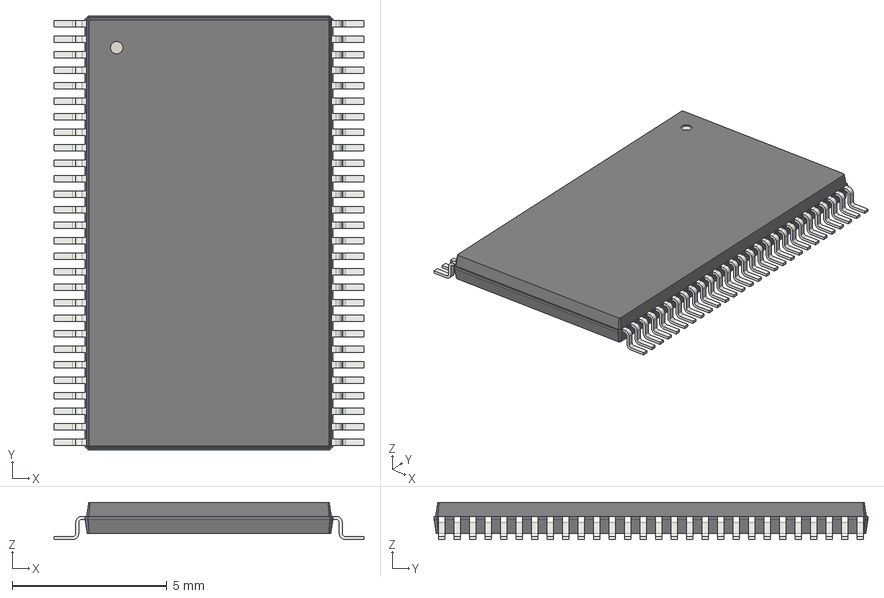
[picture p136: CAD file, 2021-02-06]
3dmodels/Package_SO/TSSOP-56_8x14mm_P0.5mm.step
10.0 x 14.0 x 1.20 mm
