joelvonrotz/KiCAD-Library/3dmodels/Package_SO/HTSSOP-14-1EP_4.4x5mm_P0.65mm_EP3.4x5mm_Mask3x3.1mm.step

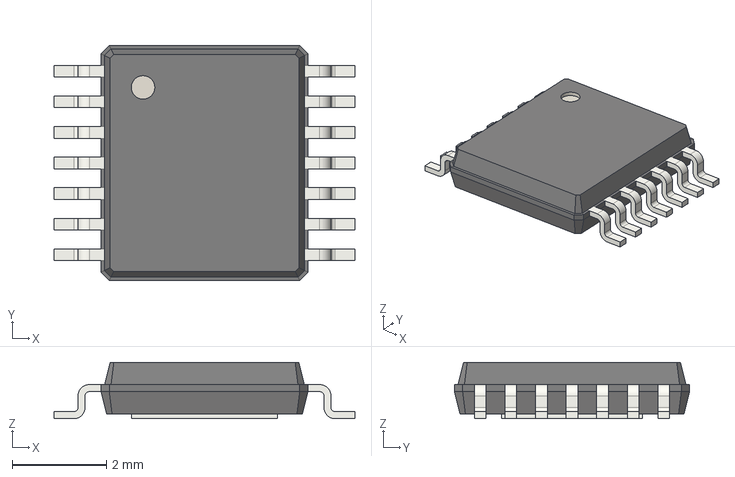
[picture p137: CAD file, 2021-02-06]
3dmodels/Package_SO/HTSSOP-14-1EP_4.4x5mm_P0.65mm_EP3.4x5mm_Mask3x3.1mm.step
6.40 x 5.00 x 1.20 mm
