joelvonrotz/KiCAD-Library/(list of files, cad)

Other CAD files:
3dmodels/Package_QFP/LQFP-48-1EP_7x7mm_P0.5mm_EP3.6x3.6mm.step
3dmodels/Package_SO/TSOP-I-32_11.8x8mm_P0.5mm.step
3dmodels/Package_QFP/LQFP-52_14x14mm_P1mm.step
3dmodels/Package_QFP/LQFP-64_10x10mm_P0.5mm.step
3dmodels/Package_QFP/PQFP-132_24x24mm_P0.635mm_i386.step
3dmodels/Package_QFP/TQFP-80-1EP_14x14mm_P0.65mm_EP9.5x9.5mm.step
3dmodels/Package_SO/MSOP-10-1EP_3x3mm_P0.5mm_EP1.68x1.88mm.step
3dmodels/Package_QFP/LQFP-80_14x14mm_P0.65mm.step
3dmodels/Package_QFP/VQFP-80_14x14mm_P0.65mm.step
3dmodels/Package_QFP/TQFP-120_14x14mm_P0.4mm.step
3dmodels/Package_SO/HTSOP-8-1EP_3.9x4.9mm_Pitch1.27mm.step
3dmodels/Package_QFP/TQFP-64_10x10mm_P0.5mm.step
3dmodels/Package_QFP/LQFP-52-1EP_10x10mm_P0.65mm_EP4.8x4.8mm.step
3dmodels/Package_SO/TSSOP-48_8x12.5mm_P0.5mm.step
3dmodels/Package_QFP/TQFP-64-1EP_10x10mm_P0.5mm_EP8x8mm.step
3dmodels/Package_QFP/LQFP-32_7x7mm_P0.8mm.step
3dmodels/Package_QFP/TQFP-64_10x10mm_Pitch0.5mm_EP8x8mm.step
3dmodels/Package_QFP/LQFP-80_10x10mm_P0.4mm.step
3dmodels/Amphenol/20021121-00010C4LF.STEP
3dmodels/Harwin/testpoints/s2761-46r.igs
3dmodels/McMaster_Screws/91290A051_Alloy Steel Socket Head Screw.STEP
3dmodels/Molex/SIM Card Holder/786463001.stp
3dmodels/Molex/USB/Mini/513870578.stp
3dmodels/Package_QFN/QFN-24-4x4mm_P0.5mm.stp
3dmodels/Package_QFP/HTQFP-64-1EP_10x10mm_P0.5mm_EP8x8mm.step
3dmodels/Package_QFP/LQFP-128_14x20mm_P0.5mm.step
3dmodels/Package_QFP/LQFP-32-1EP_5x5mm_P0.5mm_EP3.45x3.45mm.step
3dmodels/Package_QFP/LQFP-52_10x10mm_P0.65mm.step
3dmodels/Package_QFP/PQFP-44_10x10mm_P0.8mm.step
3dmodels/Package_QFP/TQFP-100-1EP_14x14mm_P0.5mm_EP5x5mm.step
3dmodels/Package_QFP/TQFP-32_7x7mm_P0.8mm.step
3dmodels/Package_QFP/TQFP-44_10x10mm_P0.8mm.step
3dmodels/Package_QFP/TQFP-52-1EP_10x10mm_P0.65mm_EP6.5x6.5mm.step
3dmodels/Package_QFP/TQFP-64_7x7mm_P0.4mm.step
3dmodels/Package_QFP/TQFP-80_14x14mm_P0.65mm.step
3dmodels/Package_QFP/VQFP-100_14x14mm_P0.5mm.step
3dmodels/Package_SO/ETSSOP-20-1EP_4.4x6.5mm_P0.65mm_EP3x4.2mm.step
3dmodels/Package_SO/HSOP-36-1EP_11.0x15.9mm_P0.65mm_SlugUp.step
3dmodels/Package_SO/HTSOP-8-1EP_3.9x4.9mm_P1.27mm_EP2.4x3.2mm.step
3dmodels/Package_SO/HTSSOP-20-1EP_4.4x6.5mm_P0.65mm_EP3.4x6.5mm.step
3dmodels/Package_SO/HTSSOP-20-1EP_4.4x6.5mm_P0.65mm_EP3.4x6.5mm_Mask2.75x3.43mm.step
3dmodels/Package_SO/HTSSOP-24-1EP_4.4x7.8mm_P0.65mm_EP3.4x7.8mm_Mask2.4x4.68mm.step
3dmodels/Package_SO/HTSSOP-28-1EP_4.4x9.7mm_P0.65mm_EP3.4x9.5mm.step
3dmodels/Package_SO/HTSSOP-32-1EP_6.1x11mm_P0.65mm_EP5.2x11mm.step
3dmodels/Package_SO/HTSSOP-38-1EP_6.1x12.5mm_P0.65mm_EP5.2x12.5mm_Mask3.39x6.35mm.step
3dmodels/Package_SO/HTSSOP-56-1EP_6.1x14mm_P0.5mm_EP3.61x6.35mm.step
3dmodels/Package_SO/Linear_MSOP-12-16-1EP_3x4mm_P0.5mm.step
3dmodels/Package_SO/MFSOP6-4_4.4x3.6mm_P1.27mm.step
3dmodels/Package_SO/MFSOP6-5_4.4x3.6mm_P1.27mm.step
3dmodels/Package_SO/MSOP-10_3x3mm_P0.5mm.step
3dmodels/Package_SO/MSOP-12-16-1EP_3x4mm_P0.5mm_EP1.65x2.85mm.step
3dmodels/Package_SO/MSOP-12-16-1EP_3x4mm_Pitch0.5mm_EP1.65x2.85mm.step
3dmodels/Package_SO/MSOP-12-1EP_3x4mm_P0.65mm_EP1.65x2.85mm.step
3dmodels/Package_SO/MSOP-12_3x4mm_P0.65mm.step
3dmodels/Package_SO/MSOP-16-1EP_3x4mm_P0.5mm_EP1.65x2.85mm.step
3dmodels/Package_SO/MSOP-16-1EP_3x4mm_Pitch0.5mm_EP1.65x2.85mm.step
3dmodels/Package_SO/MSOP-16_3x4mm_P0.5mm.step
3dmodels/Package_SO/MSOP-8-1EP_3x3mm_P0.65mm_EP2.54x2.8mm.step
3dmodels/Package_SO/MSOP-8_3x3mm_P0.65mm.step
3dmodels/Package_SO/OnSemi_Micro8.step
3dmodels/Package_SO/PSOP-44_16.9x27.17mm_P1.27mm.step
3dmodels/Package_SO/PowerIntegrations_SO-8.step
3dmodels/Package_SO/PowerIntegrations_SO-8C.step
3dmodels/Package_SO/PowerIntegrations_eSOP-12B.step
3dmodels/Package_SO/QSOP-16_3.9x4.9mm_P0.635mm.step
3dmodels/Package_SO/SO-4_4.4x2.3mm_P1.27mm.step
3dmodels/Package_SO/SO-4_7.6x3.6mm_P2.54mm.step
3dmodels/Package_SO/SO-5_4.4x3.6mm_P1.27mm.step
3dmodels/Package_SO/SO-6L_10x3.84mm_P1.27mm.step
3dmodels/Package_SO/SO-8_5.3x6.2mm_P1.27mm.step
3dmodels/Package_SO/SOIC-14W_7.5x9.0mm_P1.27mm.step
3dmodels/Package_SO/SOIC-14_3.9x8.7mm_P1.27mm.step
3dmodels/Package_SO/SOIC-16W-12_7.5x10.3mm_P1.27mm.step
3dmodels/Package_SO/SOIC-16W_5.3x10.2mm_P1.27mm.step
3dmodels/Package_SO/SOIC-16W_7.5x10.3mm_P1.27mm.step
3dmodels/Package_SO/SOIC-18W_7.5x11.6mm_P1.27mm.step
3dmodels/Package_SO/SOIC-20W_7.5x12.8mm_P1.27mm.step
3dmodels/Package_SO/SOIC-28W_7.5x17.9mm_P1.27mm.step
3dmodels/Package_SO/SOIC-28W_7.5x18.7mm_P1.27mm.step
3dmodels/Package_SO/SOIC-8-N7_3.9x4.9mm_P1.27mm.step
3dmodels/Package_SO/SOIC-8_3.9x4.9mm_P1.27mm.step
3dmodels/Package_SO/SOIC-8_5.275x5.275mm_P1.27mm.step
3dmodels/Package_SO/SOIJ-8_5.3x5.3mm_P1.27mm.step
3dmodels/Package_SO/SOJ-36_10.16x23.49mm_P1.27mm.step
3dmodels/Package_SO/SOP-16_4.4x10.4mm_P1.27mm.step
3dmodels/Package_SO/SOP-16_7.5x10.4mm_P1.27mm.step
3dmodels/Package_SO/SOP-18_7.0x12.5mm_P1.27mm.step
3dmodels/Package_SO/SOP-4_3.8x4.1mm_P2.54mm.step
3dmodels/Package_SO/SOP-4_4.4x2.6mm_P1.27mm.step
3dmodels/Package_SO/SSO-6_6.8x4.6mm_P1.27mm_Clearance7mm.step
3dmodels/Package_SO/SSO-6_6.8x4.6mm_P1.27mm_Clearance8mm.step
3dmodels/Package_SO/SSO-8_13.6x6.3mm_P1.27mm_Clearance14.2mm.step
3dmodels/Package_SO/SSO-8_6.7x9.8mm_P2.54mm_Clearance8mm.step
3dmodels/Package_SO/SSO-8_6.8x5.9mm_P1.27mm_Clearance7mm.step
3dmodels/Package_SO/SSO-8_6.8x5.9mm_P1.27mm_Clearance8mm.step
3dmodels/Package_SO/SSOP-10_3.9x4.9mm_P1.00mm.step
3dmodels/Package_SO/SSOP-14_5.3x6.2mm_P0.65mm.step
3dmodels/Package_SO/SSOP-16_3.9x4.9mm_P0.635mm.step
3dmodels/Package_SO/SSOP-16_4.4x5.2mm_P0.65mm.step
3dmodels/Package_SO/SSOP-16_5.3x6.2mm_P0.65mm.step
3dmodels/Package_SO/SSOP-18_4.4x6.5mm_P0.65mm.step
3dmodels/Package_SO/SSOP-20_4.4x6.5mm_P0.65mm.step
3dmodels/Package_SO/SSOP-20_5.3x7.2mm_P0.65mm.step
3dmodels/Package_SO/SSOP-24_5.3x8.2mm_P0.65mm.step
3dmodels/Package_SO/SSOP-28_3.9x9.9mm_P0.635mm.step
3dmodels/Package_SO/SSOP-32_11.305x20.495mm_P1.27mm.step
3dmodels/Package_SO/SSOP-44_5.3x12.8mm_P0.5mm.step
3dmodels/Package_SO/SSOP-48_7.5x15.9mm_P0.635mm.step
3dmodels/Package_SO/SSOP-8_2.95x2.8mm_P0.65mm.step
3dmodels/Package_SO/SSOP-8_3.95x5.21x3.27mm_P1.27mm.step
3dmodels/Package_SO/SSOP-8_5.25x5.24mm_P1.27mm.step
3dmodels/Package_SO/ST_MultiPowerSO-30.step
3dmodels/Package_SO/ST_PowerSSO-24_SlugDown.step
3dmodels/Package_SO/ST_PowerSSO-36_SlugDown.step
3dmodels/Package_SO/ST_PowerSSO-36_SlugUp.step
3dmodels/Package_SO/TSOP-5_1.65x3.05mm_P0.95mm.step
3dmodels/Package_SO/TSOP-I-32_18.4x8mm_P0.5mm.step
3dmodels/Package_SO/TSOP-I-48_12x18.4mm_P0.5mm.step
3dmodels/Package_SO/TSOP-II-32_21.0x10.2mm_P1.27mm.step
3dmodels/Package_SO/TSOP-II-44_10.16x18.41mm_P0.8mm.step
3dmodels/Package_SO/TSSOP-10_3x3mm_P0.5mm.step
3dmodels/Package_SO/TSSOP-14_4.4x5mm_P0.65mm.step
3dmodels/Package_SO/TSSOP-16-1EP_4.4x5mm_Pitch0.65mm_EP3.4x5mm.step
3dmodels/Package_SO/TSSOP-16_4.4x5mm_P0.65mm.step
3dmodels/Package_SO/TSSOP-20_4.4x5mm_P0.5mm.step
3dmodels/Package_SO/TSSOP-20_4.4x6.5mm_P0.65mm.step
3dmodels/Package_SO/TSSOP-24_4.4x6.5mm_P0.5mm.step
3dmodels/Package_SO/TSSOP-24_4.4x7.8mm_P0.65mm.step
3dmodels/Package_SO/TSSOP-24_6.1x7.8mm_P0.65mm.step
3dmodels/Package_SO/TSSOP-28_4.4x7.8mm_P0.5mm.step
3dmodels/Package_SO/TSSOP-28_4.4x9.7mm_P0.65mm.step
3dmodels/Package_SO/TSSOP-28_6.1x7.8mm_P0.5mm.step
3dmodels/Package_SO/TSSOP-28_6.1x9.7mm_P0.65mm.step
3dmodels/Package_SO/TSSOP-30_4.4x7.8mm_P0.5mm.step
3dmodels/Package_SO/TSSOP-30_6.1x9.7mm_P0.65mm.step
3dmodels/Package_SO/TSSOP-32_4.4x6.5mm_P0.4mm.step
3dmodels/Package_SO/TSSOP-32_6.1x11mm_P0.65mm.step
3dmodels/Package_SO/TSSOP-32_8x11mm_P0.65mm.step
3dmodels/Package_SO/TSSOP-36_4.4x7.8mm_P0.4mm.step
3dmodels/Package_SO/TSSOP-36_4.4x9.7mm_P0.5mm.step
3dmodels/Package_SO/TSSOP-36_6.1x12.5mm_P0.65mm.step
3dmodels/Package_SO/TSSOP-36_6.1x7.8mm_P0.4mm.step
3dmodels/Package_SO/TSSOP-36_6.1x9.7mm_P0.5mm.step
3dmodels/Package_SO/TSSOP-36_8x12.5mm_P0.65mm.step
3dmodels/Package_SO/TSSOP-36_8x9.7mm_P0.5mm.step
3dmodels/Package_SO/TSSOP-38_4.4x9.7mm_P0.5mm.step
3dmodels/Package_SO/TSSOP-38_6.1x12.5mm_P0.65mm.step
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
