joelvonrotz/KiCAD-Library/(commit log)

2024-02-25 renamed folder + added non-working database :(
    [513870578.stp, CAP0402.igs, CAP0402.stp, CAP0603.igs, CAP0603.stp, CAP0805.igs, CAP0805.stp, CAP1206.igs]
2024-03-18 added new 3d models
    [20021121-00010C4LF.STEP, ECS-3225_ECS.step, QFN-56-1EP_7x7mm_P0.4mm_EP5.6x5.6mm.step, QFN-56.STEP, UFQFPN-28.iges, UFQFPN-28.step, uSIP-11.iges]
2024-03-18 added some new footprints and also changing the way I handle footprints
2024-05-29 big component commit
    [418121160801.stp, PTS820J25KSMTRLFS.stp, QFN-24-4x4mm_P0.5mm.step, QFN-24-4x4mm_P0.5mm.stp, SOT1176-2.step, SOT353.step, TFQFPN24_4x4_p0.5.step, VFQFPN-16_STM.iges]
2024-10-17 added footprints of sim card holder & ublox modem
    [786463001.stp, pcb_connector_803-87-004-10-001101.stp]
2024-10-18 added jtag/swd connector
    [FTSH-105-01-L-DV-K.stp]
2024-11-03 Added TVS diode, sockets, header, etc. + Adjusted some possitions
    [APT1608.STEP, CLP-106-02-L-D.stp, CLP-112-02-L-D.stp, FTS-106-01-L-DV.stp, FTS-112-01-L-DV.stp, S2751-46R.STEP, SOT23-6L.STEP, sma_straight_tht_jack_132134.stp]
2024-11-04 added UQFN10, WQFN16 and adjusted some footprints
    [LQG15HS68NJ02D.step, LQG18HH68NJ00D.STEP, SOT363.step, UQFN10_RSW0010A.stp, WQFN10_BQB0016A.stp]
2024-11-05 added inductors, some footprints
    [91290A051_Alloy Steel Socket Head Screw.STEP, CDRH6D28.step, Pin header jumper.stp, VQFN14-FCRLF_RXB0014A.stp]
2024-11-06 changed silkscreen width to 0.15mm on all footprints
2024-12-04 big commit -> fixed some symbols and added donut :)
    [TSW-102-07-G-D.stp, pcb_connector_801-87-010-10-001101.stp]
