joelvonrotz/KiCAD-Library/(notices)

Notices in the files:
3dmodels/Package_SO/SOIC-8-1EP_3.9x4.9mm_P1.27mm_EP2.35x2.35mm.step:
Copyright (C) 2017, kicad StepUp
This work is licensed under the [Creative Commons CC-BY-SA 4.0 License](https://creativecommons.org/licenses/by-sa/4.0/legalcode),
with the following exception:
To the extent that the creation of electronic designs that use 'Licensed Material' can be considered to be 'Adapted Material',
You are free to use the library data in your own projects without the obligation to share your project files under this or any other license agreement.
3dmodels/Package_SO/TSOP-II-54_22.2x10.16mm_P0.8mm.step:
Copyright (C) 2018, kicad StepUp
3dmodels/Package_QFN/QFN-56-1EP_7x7mm_P0.4mm_EP5.6x5.6mm.step:
This program is free software: you can redistribute it and/or modify
it under the terms of the GNU General Public License as published by
the Free Software Foundation, either version 3 of the License, or
any later version.
itself might be covered by the GNU General Public License.
3dmodels/Package_SO/TSSOP-56_8x12.5mm_P0.4mm.step:
Copyright (C) 2020, kicad StepUp
